AdamLaurie/RFIDler/windows-src/images/RFIDlerMon.png

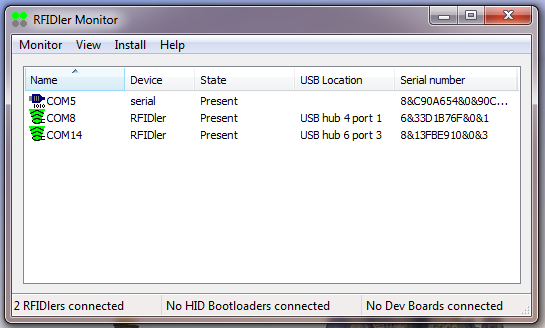
windows-src/images/RFIDlerMon.png
