AdamLaurie/RFIDler/python/example-plots/rfidler_plot_ask_recognition.png

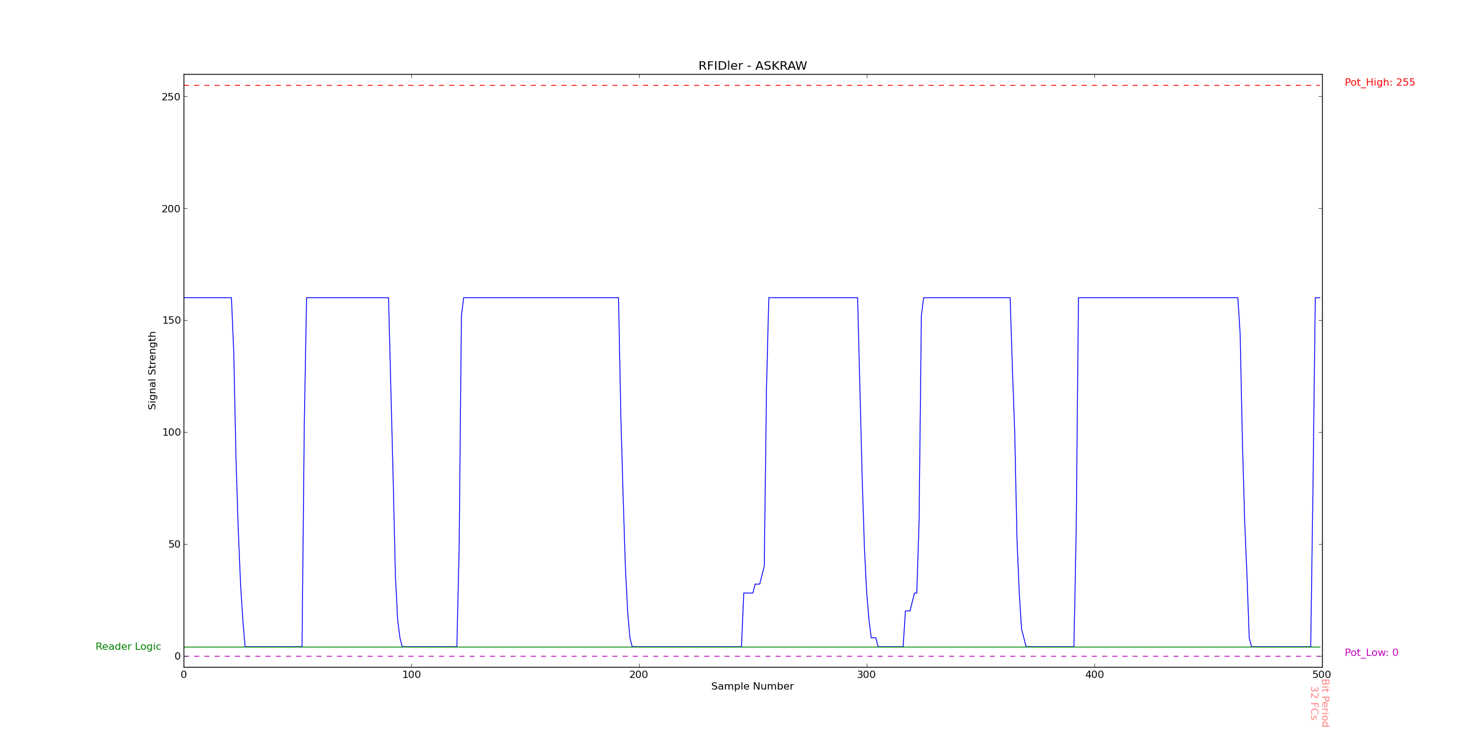
python/example-plots/rfidler_plot_ask_recognition.png
