AdamLaurie/RFIDler/python/example-plots/rfidler_plot_em4x02_134khz.png

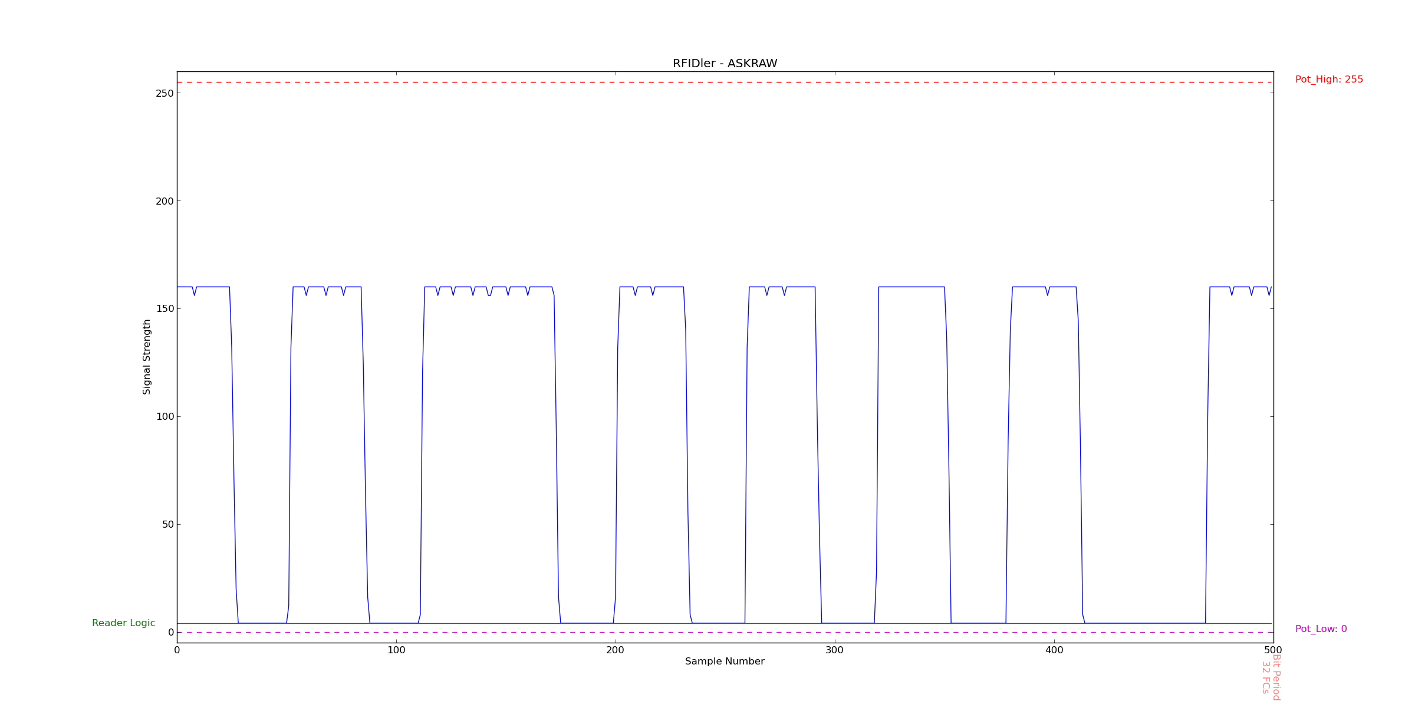
python/example-plots/rfidler_plot_em4x02_134khz.png
