AdamLaurie/RFIDler/python/example-plots/rfidler_plot_fsk_recognition.png

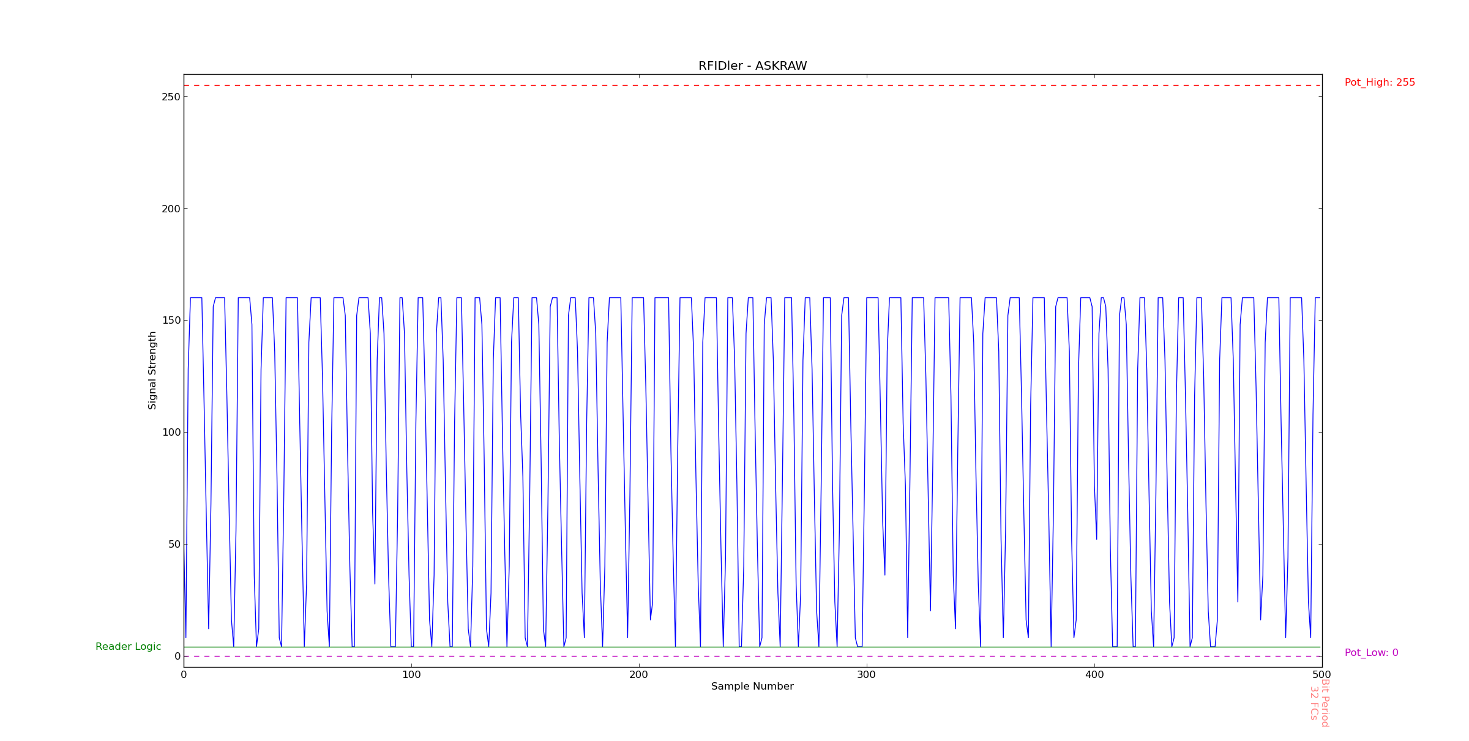
python/example-plots/rfidler_plot_fsk_recognition.png
