AdamLaurie/RFIDler/python/example-plots/rfidler_plot_hid_prox_125khz.png

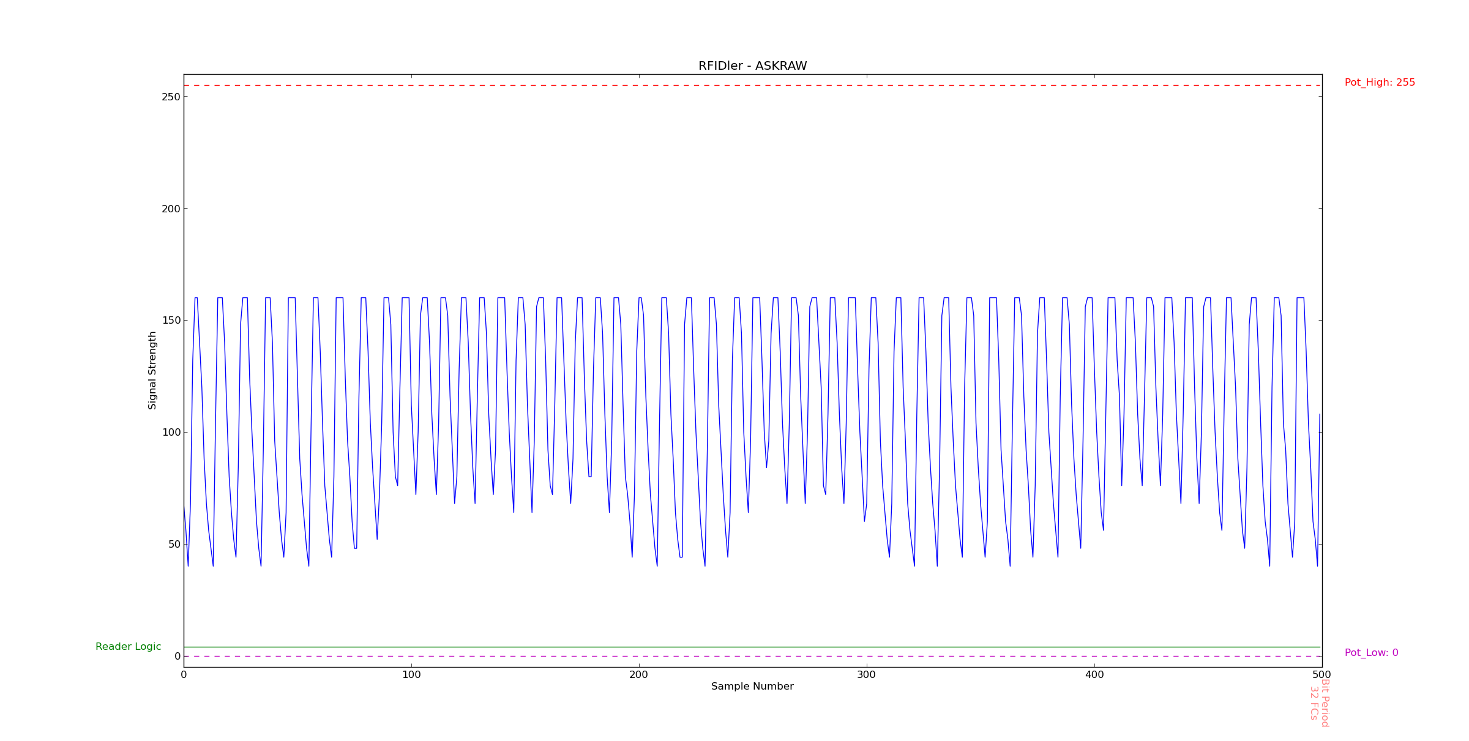
python/example-plots/rfidler_plot_hid_prox_125khz.png
