AdamLaurie/RFIDler/python/example-plots/rfidler_plot_hid_prox_134khz.png

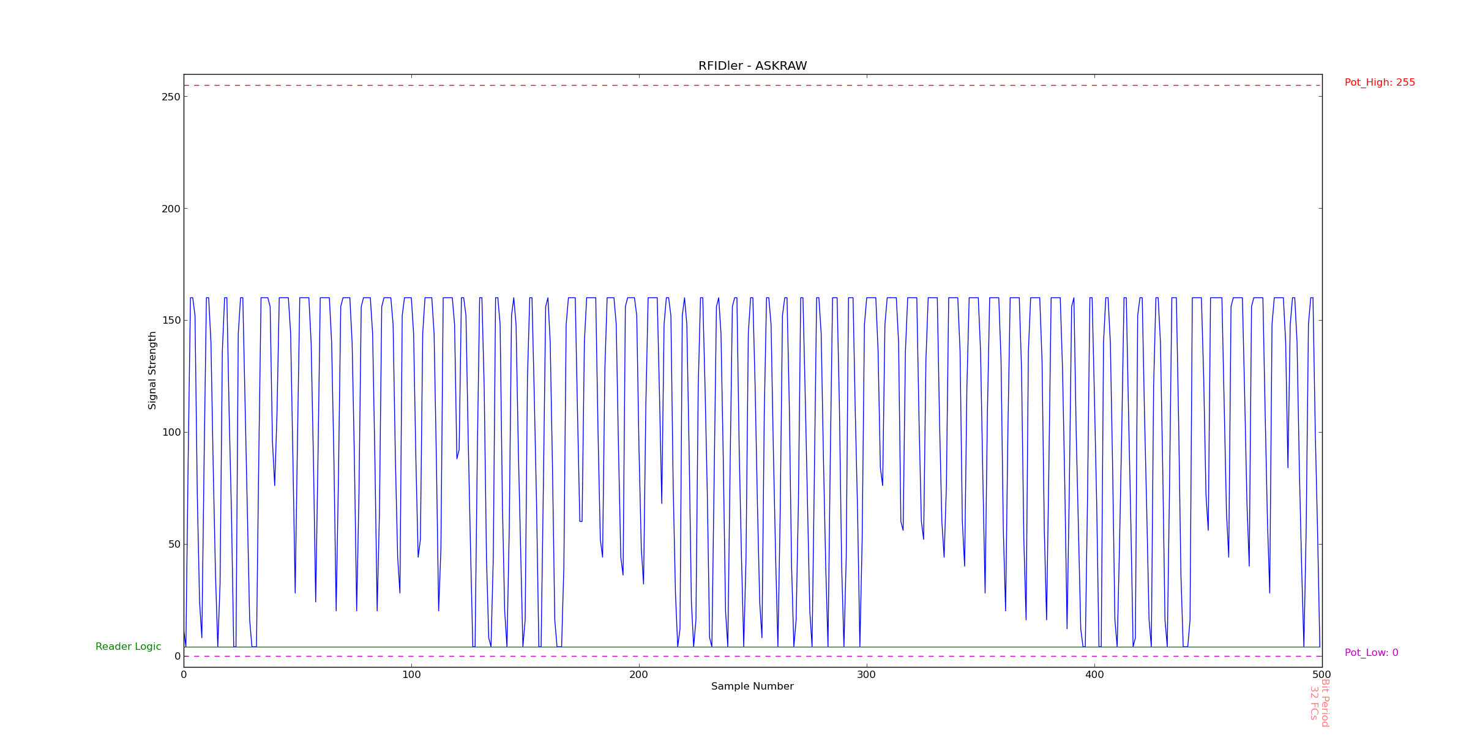
python/example-plots/rfidler_plot_hid_prox_134khz.png
