AdamLaurie/RFIDler/python/example-plots/rfidler_plot_psk_recognition.png

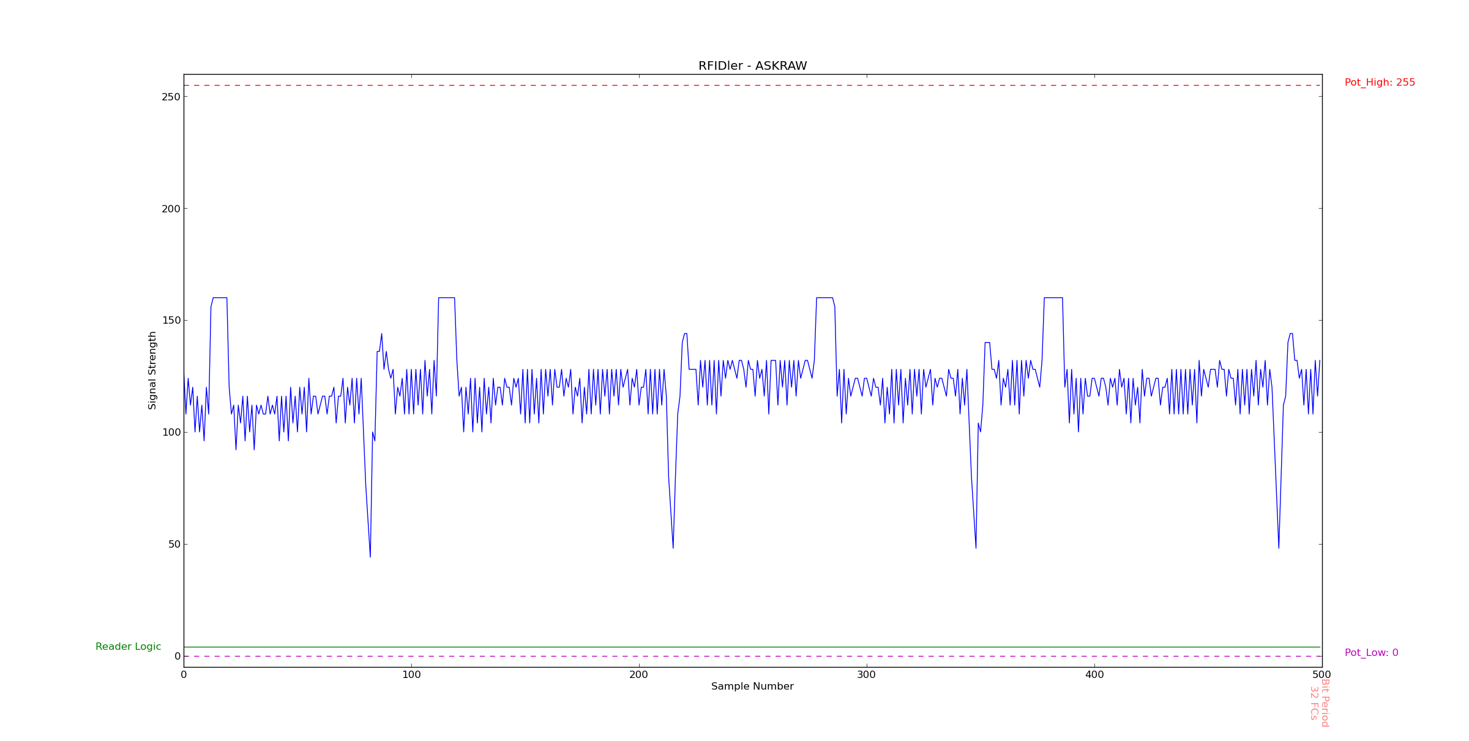
python/example-plots/rfidler_plot_psk_recognition.png
