AdamLaurie/RFIDler/windows driver/rfidler-install.txt

RFIDler LF appears to the computer as a USB serial port, and works with a standard 
Windows driver for USB serial ports, usbser.sys.

A simple driver information file rfidlercdc.inf tells Windows which driver to use, and 
such details as manufacturer (Aperture Labs Ltd) and product names (RFIDler LF).

This installer provides a simple interface to install or uninstall this file. (Note that 
complete uninstall only works on Windows XP, as Windows Vista & 7 keep a private copy.)

Alternatively to using the installer you can connect your RFIDler LF, find it in Windows 
Device Manager (via the Control Panel) and update the driver there. This program needs 
to run as local Administrator in order to copy files to, or remove files from, Windows 
protected directories.

Two versions of the installer are supplied: rfidlerinstall-x86.exe for 32-bit versions of 
Windows XP to Windows 7, and rfidlerinstall-x64.exe for 64-bit versions of Windows on x64 
CPUs.

Copyright (c) 2014 Anthony Naggs, all rights reserved.

Limited assignment of rights under the 'BSD 2-Clause License':

Redistribution and use in source and binary forms, with or without modification, are 
permitted provided that the following conditions are met:

1. Redistributions of source code must retain the above copyright notice, this list of
   conditions and the following disclaimer.

2. Redistributions in binary form must reproduce the above copyright notice, this list
   list of conditions and the following disclaimer in the documentation and/or other
   materials provided with the distribution.

THIS SOFTWARE IS PROVIDED BY THE COPYRIGHT HOLDERS AND CONTRIBUTORS "AS IS" AND ANY 
EXPRESS OR IMPLIED WARRANTIES, INCLUDING, BUT NOT LIMITED TO, THE IMPLIED WARRANTIES 
OF MERCHANTABILITY AND FITNESS FOR A PARTICULAR PURPOSE ARE DISCLAIMED. IN NO EVENT 
SHALL THE COPYRIGHT HOLDER OR CONTRIBUTORS BE LIABLE FOR ANY DIRECT, INDIRECT, 
INCIDENTAL, SPECIAL, EXEMPLARY, OR CONSEQUENTIAL DAMAGES (INCLUDING, BUT NOT LIMITED 
TO, PROCUREMENT OF SUBSTITUTE GOODS OR SERVICES; LOSS OF USE, DATA, ORPROFITS; OR 
BUSINESS INTERRUPTION) HOWEVER CAUSED AND ON ANY THEORY OF LIABILITY, WHETHER IN 
CONTRACT, STRICT LIABILITY, OR TORT (INCLUDING NEGLIGENCE OR OTHERWISE) ARISING IN 
ANY WAY OUT OF THE USE OF THIS SOFTWARE, EVEN IF ADVISED OF THE POSSIBILITY OF SUCH 
DAMAGE.
