AdamLaurie/RFIDler/python/example-plots/rfidler_plot_mystery_tag3_step1.png

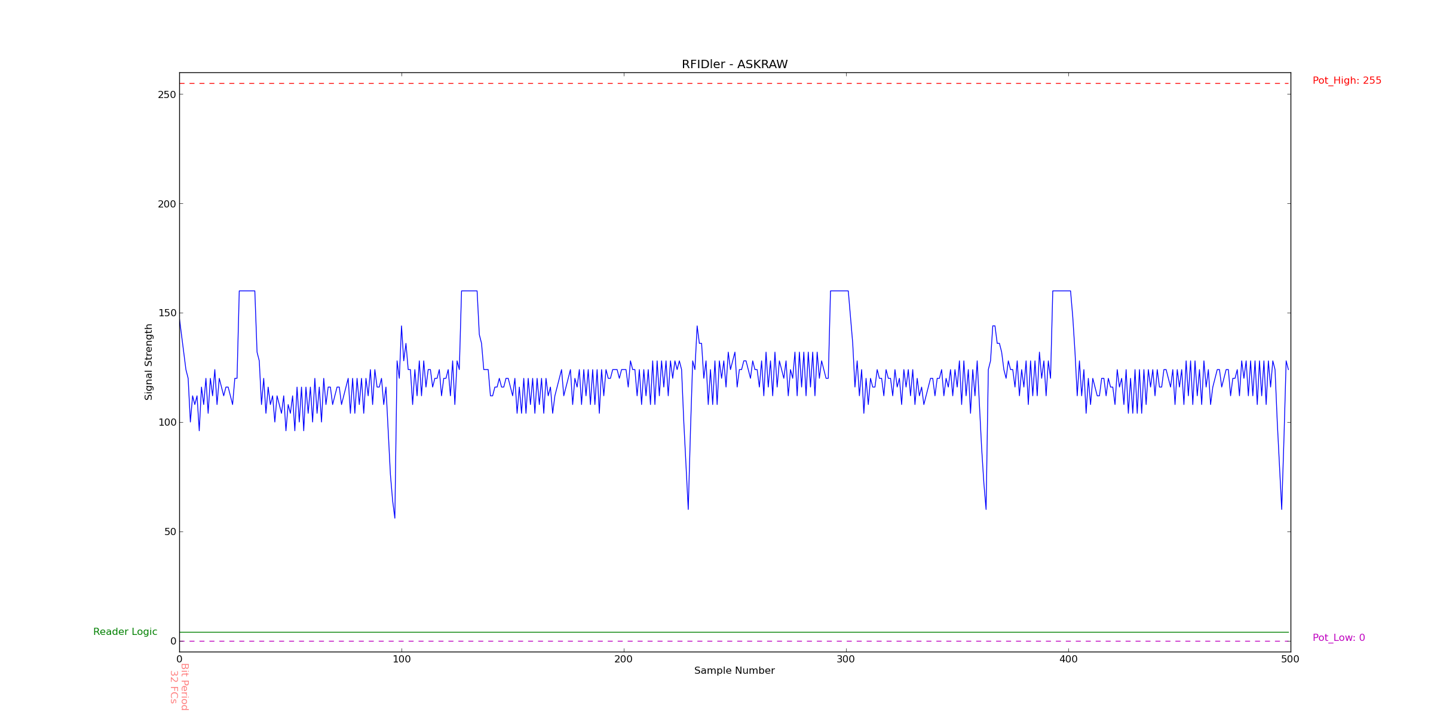
python/example-plots/rfidler_plot_mystery_tag3_step1.png
