AdamLaurie/RFIDler/python/example-plots/rfidler_plot_mystery_tag_step2.png

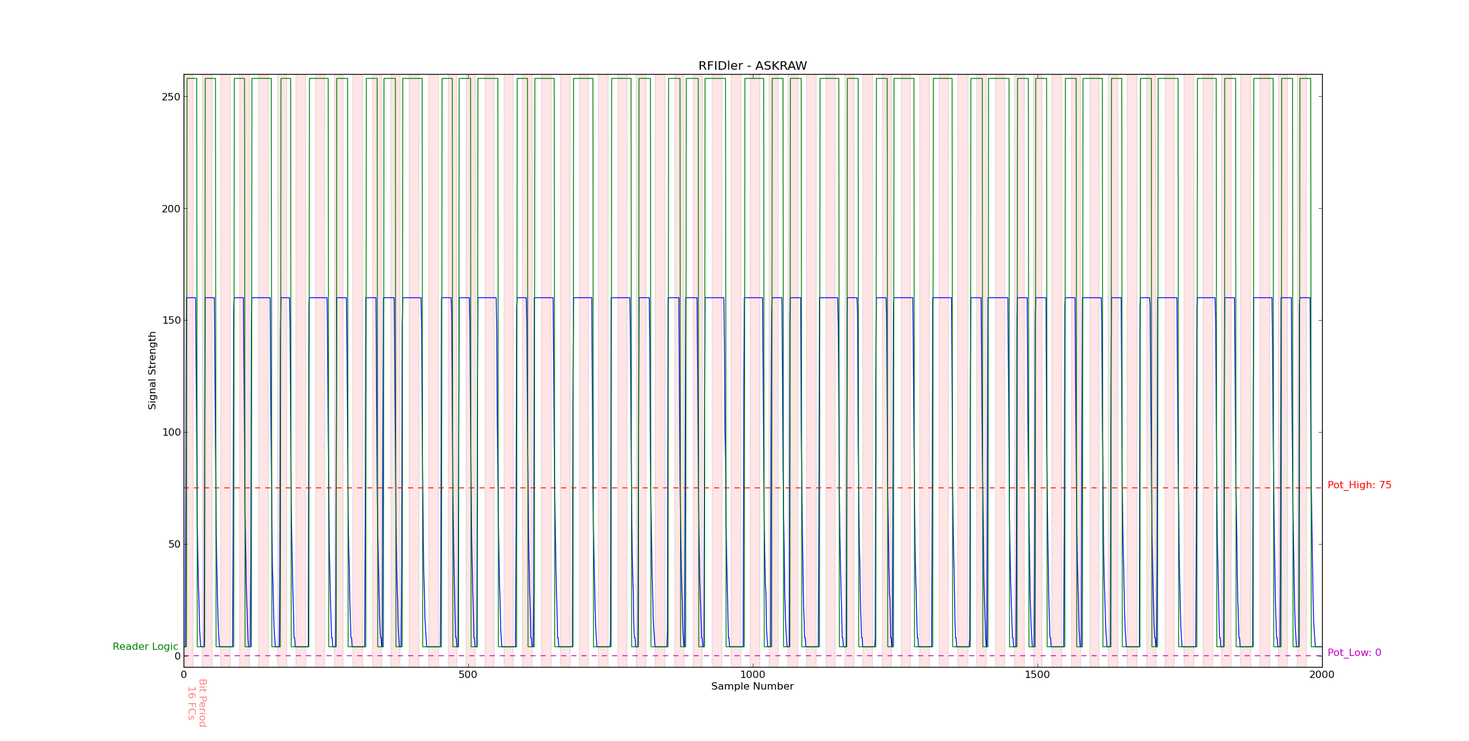
python/example-plots/rfidler_plot_mystery_tag_step2.png
