AdamLaurie/RFIDler/python/example-plots/rfidler_plot_mystery_tag_step3.png

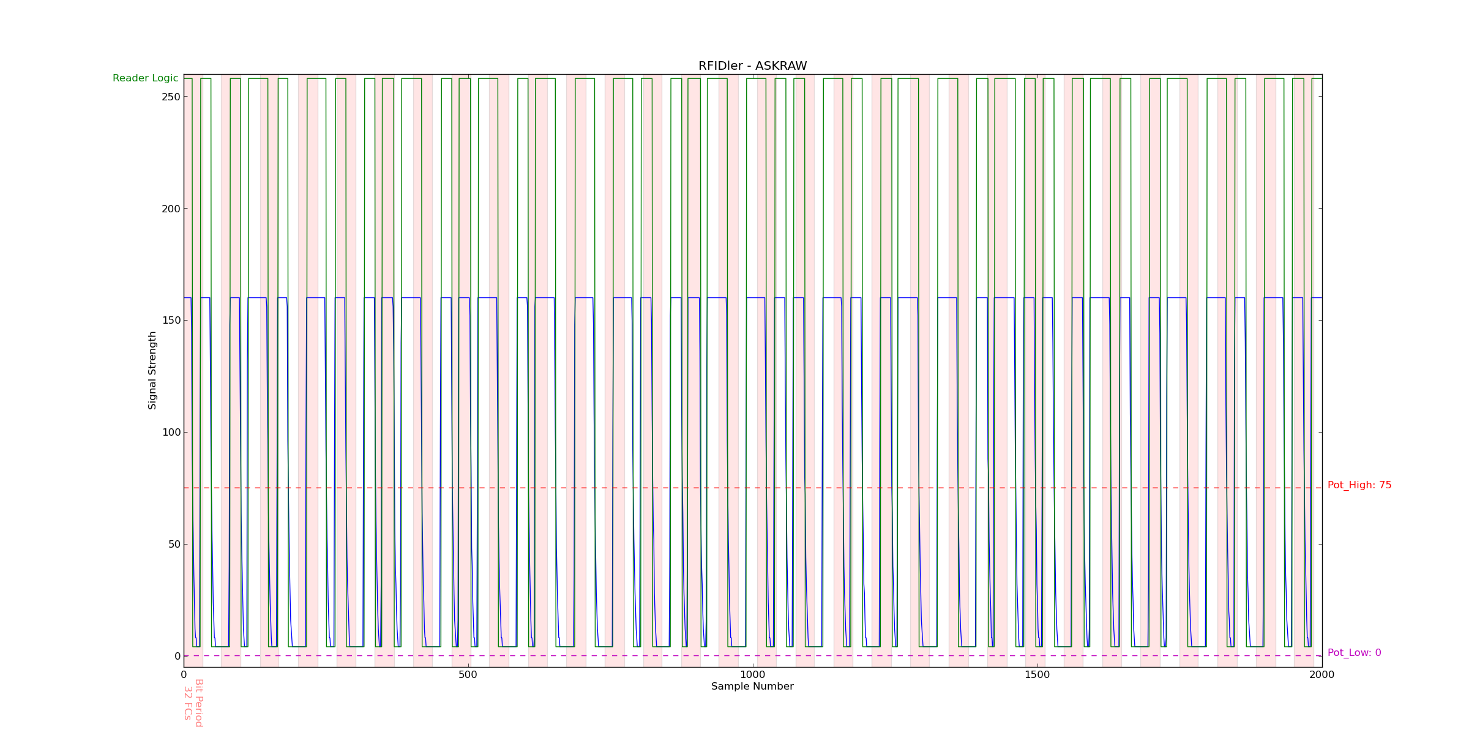
python/example-plots/rfidler_plot_mystery_tag_step3.png
