AdamLaurie/RFIDler/(threads)

Thread 26 (2015-07-18):

Complete No0B Here! How do I get this stuff working!?!

cavebear541, 2015-07-18:
I am at a complete loss as to how I am supposed to get my RFIDler working. Is there a way to just download a program that has all I need to get it working? The instructions in the read me are confusing and beyond my expertise. I need a guide for beginners!

tonynaggs, 2015-07-19:
You need a Mac, Unix or Windows PC to connect to, and USB cable with a mini USB connector to connect to the Rfidler. (I have also heard of people connecting to an Android phone with USB OTG, but you probably need external power in this case.)

The Rfidler will look like a new serial port, and you can use your favourite terminal programming to connect & talk with it.

We really need to know what you're connecting your Rfidler to, and what you have done to set it up to in order to give more specific advice!

cavebear541, 2015-07-19:
I'm connecting it to a PC.

tonynaggs, 2015-07-19:
1. Our support forum is here: [http://rfidler.org/] (http://rfidler.org/)

2. "a PC" is not sufficient information for anyone to understand your problem and help you:
    you need to state what operating system (Mac OS, Linux, Windows, etc) and version you have,
    also what you have tried (software you have installed or struggled with),
    and what does & does not work (for example do the LEDs on the Rfidler light when you plug it in).

3. Github issues are for reporting bugs in the supplied software, or feature requests.
    Using the forum for support requests means more people can read your questions and offer replies.

cavebear541, 2015-07-19:
I have Windows 7, when I plug the RFIDler into the computer the lights on the device light up.
My problem is that I don't know which software I need to be using. This website has a number of different ones it talks about using, none of which I can figure out. All I know how to do at this moment is how to plug the device into my computer. Does anyone know which software I need to download or an instruction manual is located?

tonynaggs, 2015-07-20:
Cool, I'm using Windows 7 too.

My plan this week includes blogging on:
* How to use Rfidler with Windows XP or 7, including Windows bugs to work around and what tools to install.

* Features and roadmap for the Rfidler Windows tools I have written.

Sorry these don't exist already.

fabiand93, 2015-07-25:
I'm using a Mac OS Yosemite, and I'm lost too

Closed 2015-07-19.

Thread 29 (2016-02-10):

autotag stalls at HDX

mubix, 2016-02-10:
It just stalls and never finishes

Current version: 0187-beta
```
RFIDler> version
0187-beta
RFIDler> autotag
  ASKRAW: 9<removed data>
  FSK1RAW:
  FSK2RAW:
  PSK1RAW:
  PSK2RAW:
  PSK3RAW:
  HITAG1:
  HITAG2:
  EM4X02:
  Q5:
  HID26:
  INDALA64:
  INDALA224:
  UNIQUE:
  FDXB:
  T55X7:
  AWID26:
  EM4X05:
  TAMAGOTCHI:
  HDX:

```

eficker, 2016-02-10:
I haven't had a lot of success with this function either. In my experience, the RFIDler is great at writing tags but okay at reading. The odd part is that it will write flawlessly the first time, but getting it to read (with the same provided antenna) is difficult and requires a lot of repositioning of the badge.

bvernoux, 2016-03-13:
I confirm this issue and also the fact that I have 2 TI HDX - FSK 134.2kHz tags (http://www.ti.com/lit/ds/symlink/trpgr30tgc.pdf & http://www.ti.com/lit/ds/symlink/ri-trp-r9ql.pdf) which cannot be detected correctly even using https://github.com/ApertureLabsLtd/RFIDler/wiki/plotting => with'set tag fsk2raw' with different settings (signal is too low)

AdamLaurie, 2016-03-13:
HDX is a work in progress and unfortunately I ran out of time on it when only half way through... I've disabled it altogether until I get a chance to finish it (or someone else does :). I'll leave this issue open as a reminder though.

Thread 34 (2018-01-13):

flashing firmware on windows

MarcusWolschon, 2018-01-13:
The "Windows" section in README.MD for flashing a new firmware version still only consists of "???".
The "Windows" and "MacOS" section of the "firmware" wiki page on Github are empty.

There is some information in the forum at
http://rfidler.org/index.php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
but it does not tell where to get HIDBootloader.exe

There does not seem to be named releases on Github and no obvious version.h or similar file to look up what a current version number should look like.
So I have no idea if "0114-beta" the board tells me is terribly outdated or current and
no way of updating the firmware to the latest file from firmware/Pic32/RFIDler.X/dist/debug/production/RFIDler.X.production.hex

MarcusWolschon, 2018-01-13:
I seem to have found the current place to download binaries of the flashing application.
This is what should be in the readme:
http://marcuswolschon.blogspot.de/2018/01/using-rfidler-on-windows.html

Also a wiki page or something explaining all the CLI commands would be reasonable.

Thread 37 (2019-11-28):

Hitag2 SNIFF-PWM list stored

banannd, 2019-11-28:
Hi,
 I have problem with SNIFF-PWM list stored option, becouse when I do procedure on my RFIDler:
SET TAG HITAG2
SNIFF-PWM C
AUTORUN SNIFF-PWM S
SAVE
• Power RFIDler from USB battery
• RFIDler antenna on RWD, present tag (n times)
and comands "SNIFF-PWM L" return:
"No HiTag2 PWM stored"
where is the problem?

Thread 40 (2020-10-02):

new crack2,3,4 usage

p3im4n, 2020-10-02:
hi
at first I apologize for my bad english
Special thanks to Mr AdamLaurie for his great RFIDlr device
after weeks finally I could compile mcu and windows projects,but there is no usage of hitag2crack folder and its  cracks source file!!
although Author(Kevin Sheldrakein) describes how to use these cracks by RFIDlr device in README file
is any one there who try that cracks ?
best regards

Thread 45 (2024-07-16):

http://rfidiot.org/ Down?

HeIp, 2024-07-16:
[http://rfidiot.org/](http://rfidiot.org/#Hardware) website seems to not be working ?

SteveClement, 2024-07-18:
Indeed :( @AdamLaurie

AdamLaurie, 2024-07-18:
Yes - I'm working on it. My service provider had a major outage and lost
the VM it was running on :(

Thanks for the head's up!

Hope you're well!

cheers,
Adam

On Thu, Jul 18, 2024 at 3:53 PM Steve Clement ***@***.***>
wrote:

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
