AdamLaurie/RFIDler/Hardware/Pic32/RFIDLER V22 beta.brd

## EAGLE design Hardware/Pic32/RFIDLER V22 beta.brd (2014-06-19)

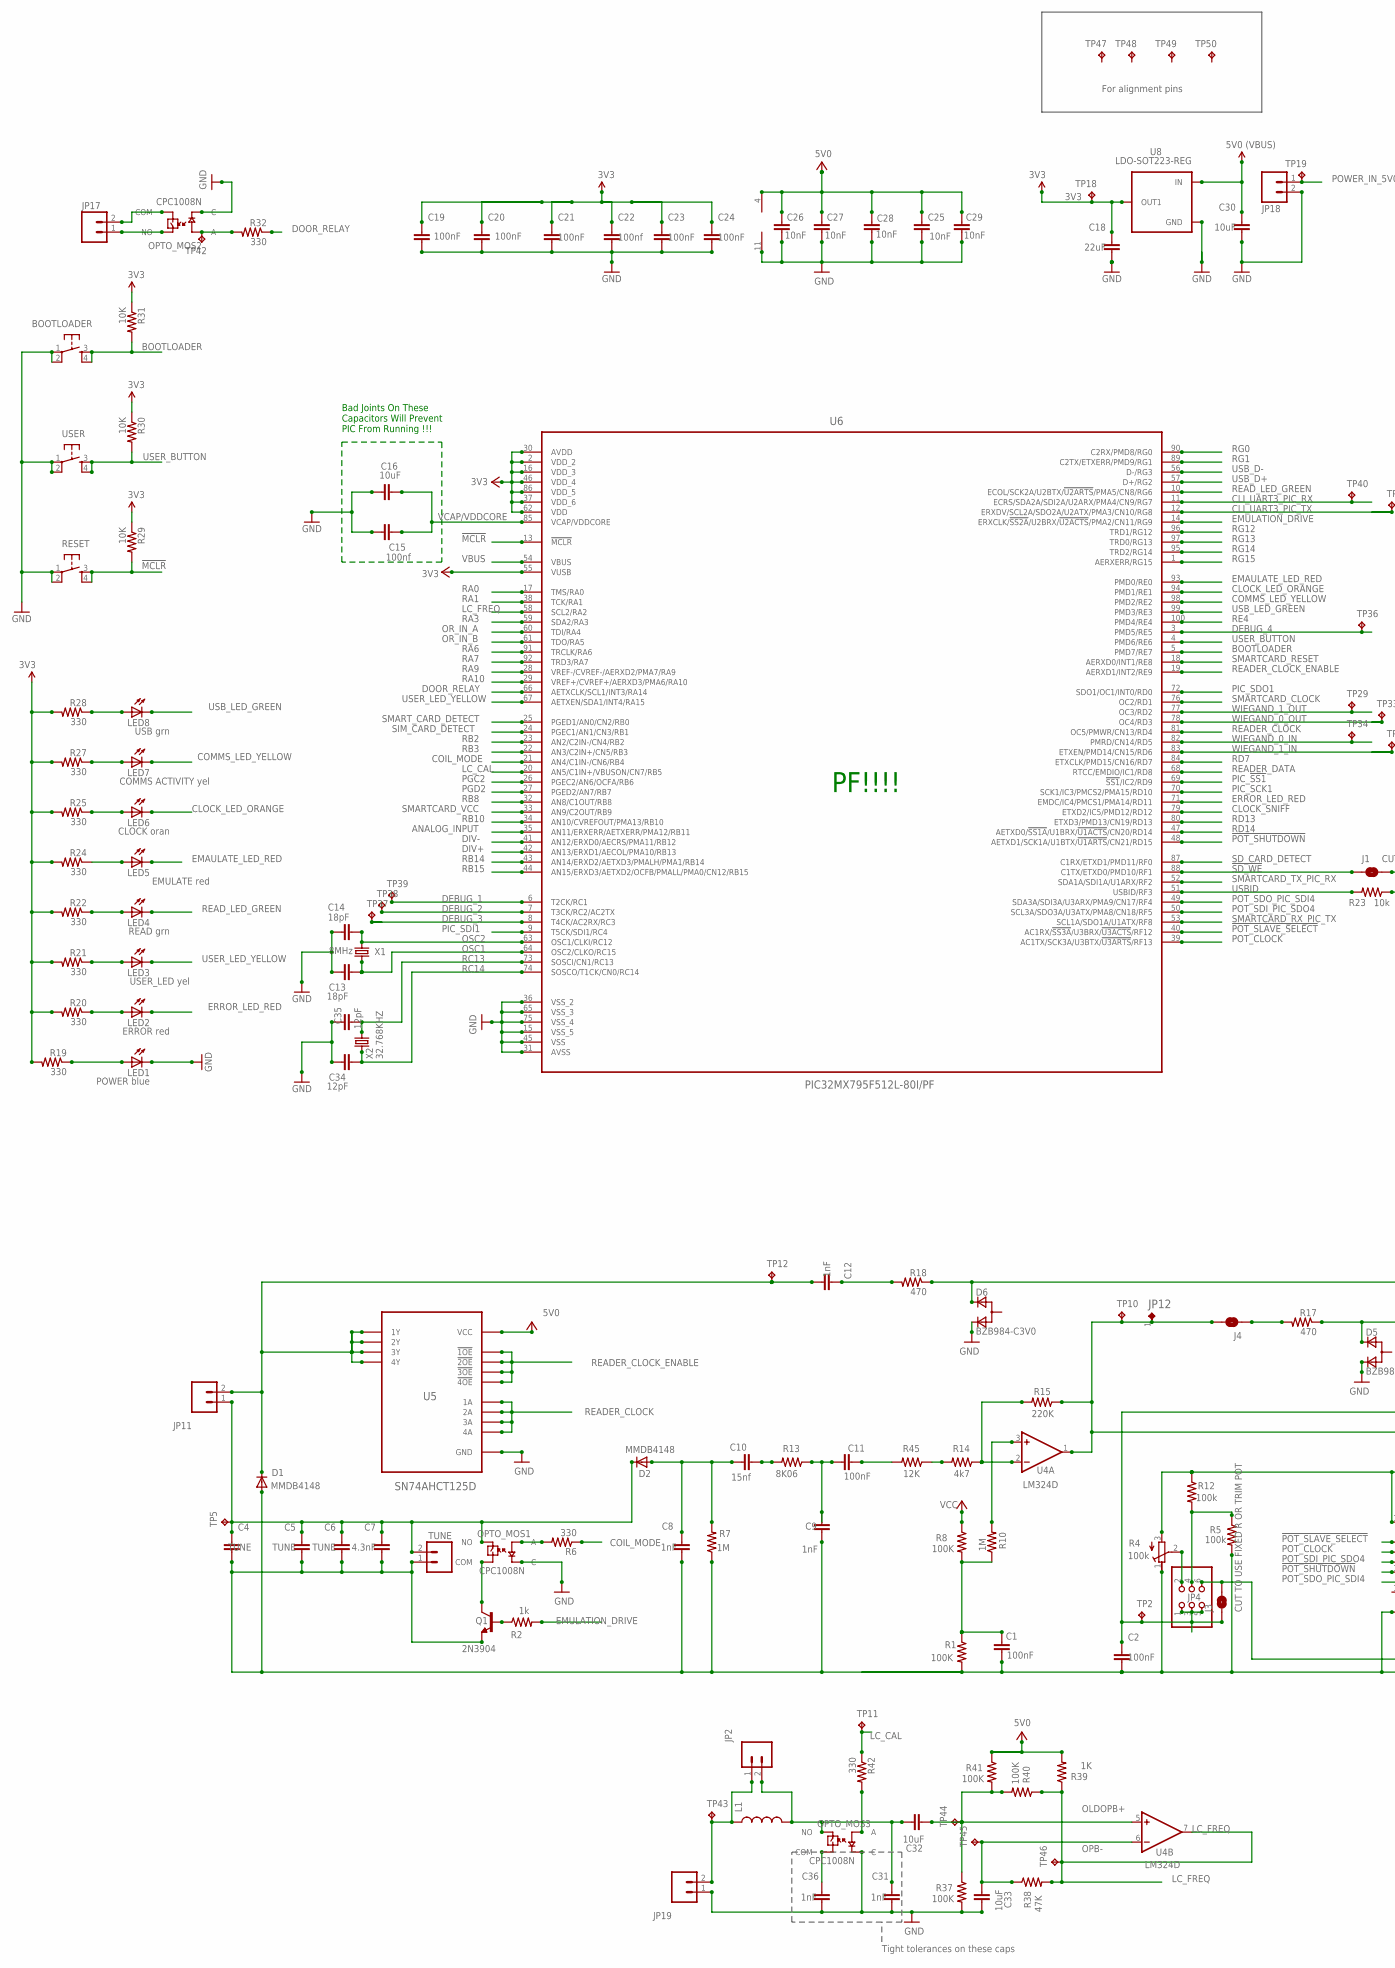
[picture p18: schematic RFIDLER V22 beta.sch, part in row 1, column 1]

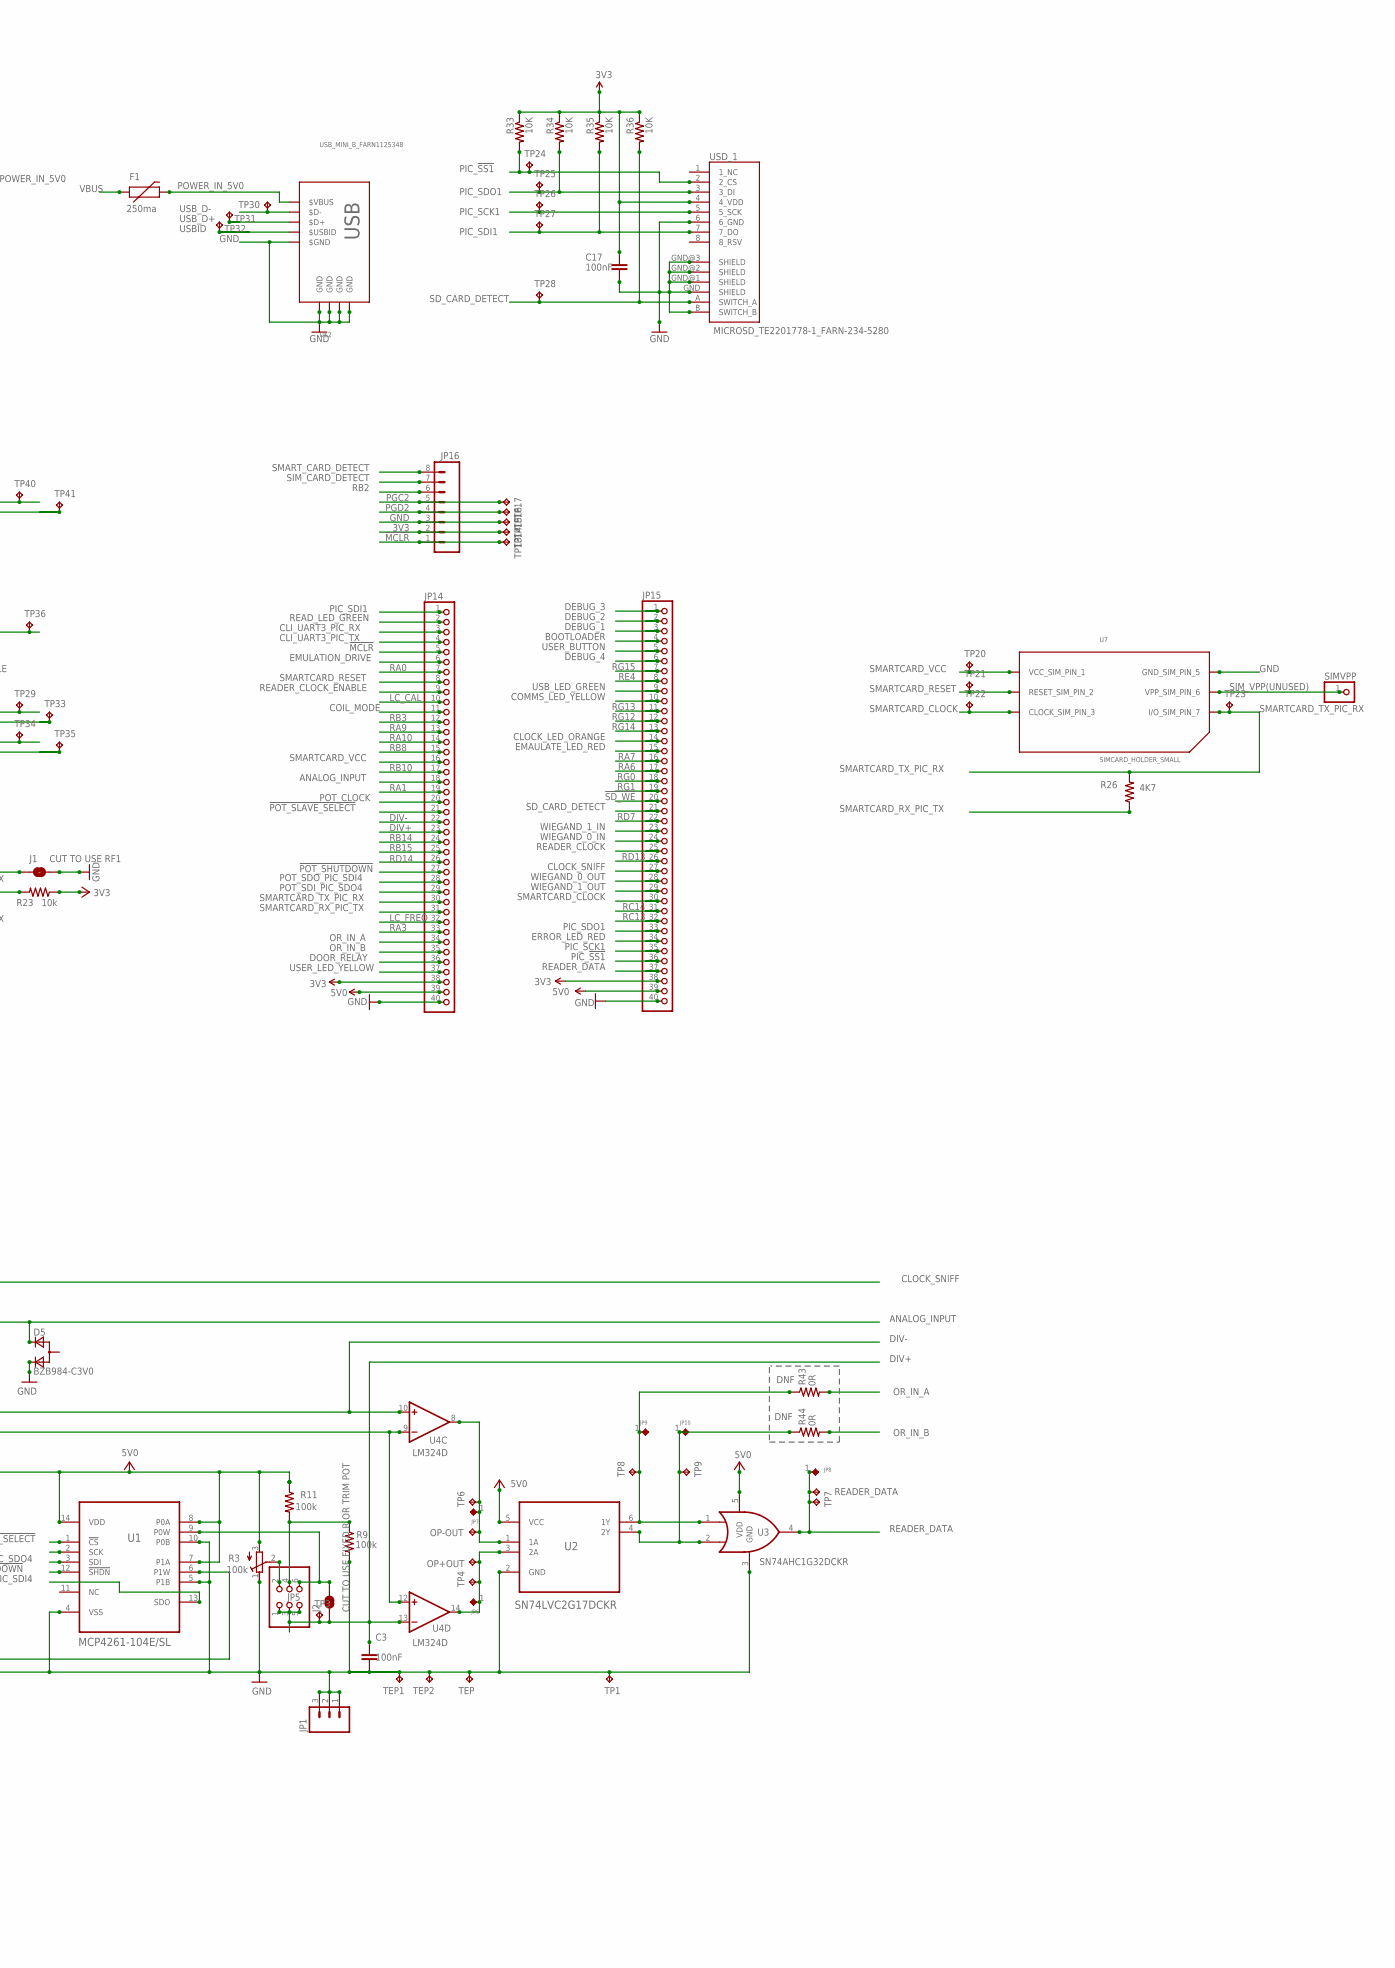
[picture p19: schematic RFIDLER V22 beta.sch, part in row 1, column 2]

Parts:
BOOTLOADER: TAC_SWITCHSMD; TACTILE_SWITCH_SMD; TOLERANCE ?; FARNELL 9471880
C1: 100nF; 0603-CAP; TOLERANCE ?; PARTNO currently rs 264-4646; FARNELL 2332586
C2: 100nF; C0603; TOLERANCE ?; PARTNO currently rs 264-4646; FARNELL 2332586
C3: 100nF; C0603; TOLERANCE ?; PARTNO ?; FARNELL 2332586
C4, C5, C6: TUNE; C0603; TOLERANCE ?; PARTNO ?; FARNELL DNF
C7: 4.3nF; C0603; TOLERANCE 1%; PARTNO ?; FARNELL 1865494
C8, C9, C12: 1nF; C0603; TOLERANCE ?; PARTNO ?; FARNELL 1414606
C10: 15nf; C0603; TOLERANCE ?; PARTNO ?; FARNELL 2070401
C11: 100nF; C0603; TOLERANCE ?; PARTNO currently rs2644646; FARNELL 2332586
C13, C14: 18pF; C0603; TOLERANCE ?; FARNELL 1612182
C15: 100nf; C0603; TOLERANCE Cuurently rs 264 4646; FARNELL 2332586
C16, C30: 10uF; C0805; TOLERANCE ?; FARNELL 1867958
C17: 100nF; C0603; TOLERANCE Crrently rs 264 4646; FARNELL DNF
C18: 22uF; C0805; TOLERANCE ?; FARNELL 1867956
C19, C20, C21, C23, C24: 100nF; C0603; TOLERANCE Crrently rs 264 4646; FARNELL 2332586
C22: 100nf; C0603; TOLERANCE Crrently rs 264 4646; FARNELL 2332586
C25, C26, C27, C28, C29: 10nF; C0603; TOLERANCE ?; PARTNO ?; FARNELL 1301715
C31, C36: 1nF; C0603; TOLERANCE ?; PARTNO ?; FARNELL DNF
C32, C33: 10uF; C0805; TOLERANCE ?; FARNELL DNF
C34, C35: 12pF; C0603; TOLERANCE ?; FARNELL DNF
D1, D2: MMDB4148; SOT23-3; TOLERANCE ?; PARTNO ?; FARNELL 2069338
D5, D6: BZB984-C3V0; SOT663; FARNELL 8735310
F1: 250ma; PTC-1206; FARNELL 1596990
J1: CUT TO USE RF1; SJ_2S-TRACE
J2, J3: CUT TO USE FIXED R OR TRIM POT; SJ_2S-TRACE
J4: SOLDERJUMPERTRACE; SJ_2S-TRACE
JP1: M03LOCK_LONGPADS; 1X03_LOCK_LONGPADS; FARNELL DNF
JP2, JP18, JP19: M02LOCK_LONGPADS; 1X02_LOCK_LONGPADS; TOLERANCE ?; PARTNO ?; FARNELL DNF
JP4, JP5: PINHD-2X3; 2X03; TOLERANCE ?; PARTNO ?; FARNELL DNF
JP6, JP7, JP8, JP9, JP10, JP12: PINHD-1X1; 1X01; TOLERANCE ?; FARNELL DNF
JP11: M02LOCK_LONGPADS; 1X02_LOCK_LONGPADS; TOLERANCE ?; PARTNO ?; FARNELL 1550562 standard 2 PIN HEADER
JP14, JP15: PINHD-1X40; 1X40; FARNELL DNF
JP16: M08; 1X08; TOLERANCE ?; FARNELL DNF
JP17: M02LOCK_LONGPADS; 1X02_LOCK_LONGPADS; FARNELL DNF
L1: INDUCTOR0603; 0603; FARNELL DNF
LED1: POWER blue; LED-0603; TOLERANCE ?; FARNELL 2217972
LED2: ERROR red; LED-0603; TOLERANCE ?; FARNELL 2099221
LED3: USER_LED yel; LED-0603; TOLERANCE ?; FARNELL 2146436
LED4: READ grn; LED-0603; TOLERANCE ?; FARNELL 2146434
LED5: EMULATE red; LED-0603; TOLERANCE ?; FARNELL 2099221
LED6: CLOCK oran; LED-0603; TOLERANCE ?; FARNELL 2146433
LED7: COMMS ACTIVITY yel; LED-0603; TOLERANCE ?; FARNELL 2146436
LED8: USB grn; LED-0603; TOLERANCE ?; FARNELL 2146434
OP+OUT: TPPAD1-13; P1-13; TOLERANCE ?; PARTNO ?; FARNELL ?
OP-OUT: TPPAD1-13; P1-13; TOLERANCE ?; PARTNO ?; FARNELL ?
OPTO_MOS1: CPC1008N; FARNELL 1653755
OPTO_MOS2, OPTO_MOS3: CPC1008N; FARNELL DNF
Q1: 2N3904; SOT323; TOLERANCE ?; PARTNO ?; FARNELL 1459102
R1, R8: 100K; R0603; TOLERANCE ?; PARTNO ?; FARNELL 9330402
R2: 1k; R0603; TOLERANCE ?; PARTNO ?; FARNELL 9238484
R3, R4: 100k; RTRIMT93XA; TOLERANCE ?; PARTNO ?; FARNELL DNF
R5, R9, R11, R12: 100k; R0603; TOLERANCE ?; PARTNO ?; FARNELL 9330402
R6, R19, R20, R21, R22, R24, R25, R27, R28: 330; R0603; TOLERANCE ?; FARNELL 9332014
R7, R10: 1M; R0603; TOLERANCE ?; PARTNO ?; FARNELL 1469746
R13: 8K06; R0603; TOLERANCE ?; PARTNO ?; FARNELL 1170881
R14: 4k7; R0603; TOLERANCE ?; PARTNO ?; FARNELL 2078913
R15: 220K; R0603; TOLERANCE ?; PARTNO ?; FARNELL 2073431
R17, R18: 470; R0603; TOLERANCE ?; FARNELL 2333530
R23: 10k; R0603; TOLERANCE ?; PARTNO ?; FARNELL 9330399
R26: 4K7; R0603; TOLERANCE ?; PARTNO ?; FARNELL DNF
R29, R30, R31: 10K; R0603; TOLERANCE ?; FARNELL 9330399
R32, R42: 330; R0603; TOLERANCE ?; FARNELL DNF
R33, R34, R35, R36: 10K; R0603; TOLERANCE ?; FARNELL DNF
R37, R40, R41: 100K; R0603; TOLERANCE ?; PARTNO ?; FARNELL DNF
R38: 47K; R0603; TOLERANCE ?; PARTNO ?; FARNELL DNF
R39: 1K; R0603; TOLERANCE ?; PARTNO ?; FARNELL DNF
R43, R44: 0R; R0603; TOLERANCE ?; PARTNO ?; FARNELL DNF
R45: 12K; R0603; TOLERANCE ?; PARTNO ?; FARNELL 1652834
READER_DATA: TPPAD1-13; P1-13; TOLERANCE ?; PARTNO ?; FARNELL DNF
RESET: TAC_SWITCHSMD; TACTILE_SWITCH_SMD; TOLERANCE ?; FARNELL 9471880
SIMVPP: PINHD-1X1; 1X01; FARNELL DNF
TEP, TEP1, TEP2: TPPAD1-13; P1-13; TOLERANCE ?; PARTNO ?; FARNELL DNF
TP1, TP9, TP18: DOWNS_ORIN1; TP20R
TP2: DIV-; TP20R
TP3: DIV+; TP20R
TP4: OP-OUT; TP20R
TP5: COIL_B; TP20R
TP6: OP+OUT; TP20R
TP7: READER_DATA; TP20R
TP8: UPS_ORIN1; TP20R
TP10: RAW_READER_OUT; TP20R
TP11: LC_CAL; TP20R
TP12: COIL_A; TP20R
TP13: !MCLR; TP20R
TP14: 3V3; TP20R
TP15: GND; TP20R
TP16: PGD2; TP20R
TP17: PGC2; TP20R
TP19: POWER_IN_5V0; TP20R
TP20: SMARTCARD_VCC; TP20R
TP21: SMARTCARD_RESET; TP20R
TP22: SMARTCARD_CLOCK; TP20R
TP23: SMARTCARD_TX_PIC_RX; TP20R
TP24: PIC_!SS1; TP20R
TP25: PIC_SDO1; TP20R
TP26: PIC_SCK1; TP20R
TP27: PIC_SDI1; TP20R
TP28: SD_CARD_DETECT; TP20R
TP29: WIEGAND_1_OUT; TP20R
TP30: USB_D-; TP20R
TP31: USB_D+; TP20R
TP32: USBID; TP20R
TP33: WIE0OUT; TP20R
TP34: WIE0IN; TP20R
TP35: WIE1IN; TP20R
TP36: DEBUG_4; TP20R
TP37: DEBUG_3; TP20R
TP38: DEBUG_2; TP20R
TP39: DEBUG_1; TP20R
TP40: CLI_UART3_PIC_RX; TP20R
TP41: CLI_UART3_PIC_TX; TP20R
TP42: RELAY; TP20R
TP43: LC_COIL; TP20R
TP44: LC+; TP20R
TP45: LC-; TP20R
TP46: LCOUT; TP20R
TP47: PEG4; TP20R
TP48: PEG1; TP20R
TP49: PEG3; TP20R
TP50: PEG2; TP20R
TUNE: M02LOCK_LONGPADS; 1X02_LOCK_LONGPADS; TOLERANCE ?; PARTNO ?; FARNELL DNF
U1: MCP4261-104E/SL; SOIC127P600X175-14N; TOLERANCE ?; PARTNO ?; FARNELL 1840694
U2: SN74LVC2G17DCKR; SOT65P210X110-6N; TOLERANCE ?; PARTNO ?; FARNELL 1287569
U3: SN74AHC1G32DCKR; SC70-5L; TOLERANCE ?; PARTNO ?; FARNELL 1287449
U4: LM324D; SO14; TOLERANCE ?; PARTNO ?; FARNELL 8389233
U5: SN74AHCT125D; SOIC127P600X175-14N; FARNELL 1287453
U6: PIC32MX795F512L-80I/PF; QFP50P1600X1600X120-100N; TOLERANCE ?; FARNELL 1778491
U7: SIMCARD_HOLDER_SMALL; SIM_CARD_CONN; FARNELL DNF
U8: LDO-SOT223-REG; SOT223; FARNELL 9778195
U$2: USB_MINI_B_FARN1125348; FARNELL 1125348
USD_1: MICROSD_TE2201778-1_FARN-234-5280; FARNELL DNF
USER: TAC_SWITCHSMD; TACTILE_SWITCH_SMD; TOLERANCE ?; FARNELL 9471880
X1: 8MHz; HC49UP; TOLERANCE ?; FARNELL 1842346
X2: 32.768KHZ; TC38H; FARNELL DNF

Connections:
3V3: C17.1, C18.1, C19.1, C20.1, C21.1, C22.1, C23.1, C24.1, JP14.38, JP15.38, JP16.2, R19.2, R20.2, R21.2, R22.2, R23.1, R24.2, R25.2, R27.2, R28.2, R29.1, R30.1, R31.1, R33.1, R34.1, R35.1, R36.1, TP14.TP, TP18.TP, U6.2 (VDD_2), U6.16 (VDD_3), U6.30 (AVDD), U6.37 (VDD_6), U6.46 (VDD_4), U6.55 (VUSB), U6.62 (VDD), U6.86 (VDD_5), U8.P$2@2 (OUT1), USD_1.4 (4_VDD)
!MCLR: JP14.5, JP16.1, R29.2, RESET.3, RESET.4, TP13.TP, U6.13 (!MCLR)
!POT_SHUTDOWN: JP14.27, U1.12 (!SHDN), U6.48 (AETXD1/SCK1A/U1BTX/!U1ARTS!/CN21/RD15)
!POT_SLAVE_SELECT: JP14.21, U1.1 (!CS), U6.40 (AC1RX/!SS3A!/U3BRX/!U3ACTS!/RF12)
!SD_WE: J1.1, JP15.20, U6.88 (C1TX/ETXD0/PMD10/RF1)
ANALOG_INPUT: D5.P$1 (C1), JP14.18, R17.1, U6.35 (AN11/ERXERR/AETXERR/PMA12/RB11)
BOOTLOADER: BOOTLOADER.3, BOOTLOADER.4, JP15.4, R31.2, U6.5 (PMD7/RE7)
CLI_UART3_PIC_RX: JP14.3, TP40.TP, U6.11 (ECRS/SDA2A/SDI2A/U2ARX/PMA4/CN9/RG7)
CLI_UART3_PIC_TX: JP14.4, TP41.TP, U6.12 (ERXDV/SCL2A/SDO2A/U2ATX/PMA3/CN10/RG8)
CLOCK: C12.2, D1.3 (C), JP11.2, TP12.TP, U5.3 (1Y), U5.6 (2Y), U5.8 (3Y), U5.11 (4Y)
CLOCK_LED_ORANGE: JP15.14, LED6.C, U6.94 (PMD1/RE1)
CLOCK_SNIFF: D6.P$1 (C1), JP15.27, R18.1, U6.79 (ETXD2/IC5/PMD12/RD12)
COIL: C4.1, C5.1, C6.1, C7.1, D2.3 (C), JP11.1, OPTO_MOS1.NO, TP5.TP, TUNE.2
COIL_MODE: JP14.11, R6.1, U6.21 (AN4/C1IN-/CN6/RB4)
COMMS_LED_YELLOW: JP15.10, LED7.C, U6.98 (PMD2/RE2)
DEBUG_1: JP15.3, TP39.TP, U6.6 (T2CK/RC1)
DEBUG_2: JP15.2, TP38.TP, U6.7 (T3CK/RC2/AC2TX)
DEBUG_3: JP15.1, TP37.TP, U6.8 (T4CK/AC2RX/RC3)
DEBUG_4: JP15.6, TP36.TP, U6.3 (PMD5/RE5)
DIV+: C3.1, J2.1, JP5.1, JP5.3, JP5.5, JP14.23, TP3.TP, U4.13 (-IN), U6.42 (AN13/ERXD1/AECOL/PMA10/RB13)
DIV-: C2.1, J3.1, JP4.1, JP4.3, JP4.5, JP14.22, TP2.TP, U4.10 (+IN), U6.41 (AN12/ERXD0/AECRS/PMA11/RB12)
DOOR_RELAY: JP14.36, R32.1, U6.66 (AETXCLK/SCL1/INT3/RA14)
DOWNS_ORIN1: JP10.1, R44.1, TP9.TP, U2.4 (2Y), U3.2 (B)
EMAULATE_LED_RED: JP15.15, LED5.C, U6.93 (PMD0/RE0)
EMULATION_DRIVE: JP14.6, R2.2, U6.14 (ERXCLK/!SS2A!/U2BRX/!U2ACTS!/PMA2/CN11/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)
ERROR_LED_RED: JP15.34, LED2.C, U6.71 (EMDC/IC4/PMCS1/PMA14/RD11)
GND: BOOTLOADER.1, BOOTLOADER.2, C1.2, C2.2, C3.2, C4.2, C5.2, C6.2, C7.2, C8.2, C9.1, C13.1, C14.1, C15.2, C16.2, C17.2, C18.2, C19.2, C20.2, C21.2, C22.2, C23.2, C24.2, C25.1, C26.2, C27.2, C28.2, C29.2, C30.2, C31.2, C33.1, C34.1, C35.1, C36.2, D1.1 (A), D5.P$2 (C2), D6.P$2 (C2), J1.2, JP1.1, JP1.2, JP1.3, JP14.40, JP15.40, JP16.3, JP18.2, JP19.1, LED1.C, OPTO_MOS1.C, OPTO_MOS2.C, OPTO_MOS3.C, Q1.3 (E), R1.2, R3.1 (A), R4.1 (A), R5.2, R7.1, R9.2, R37.2, RESET.1, RESET.2, TEP.TP, TEP1.TP, TEP2.TP, TP1.TP, TP15.TP, TUNE.1, U1.4 (VSS), U1.5 (P1B), U1.10 (P0B), U2.2 (GND), U3.3 (GND), U4.11 (V-), U5.7 (GND), U6.15 (VSS_5), U6.31 (AVSS), U6.36 (VSS_2), U6.45 (VSS), U6.65 (VSS_3), U6.75 (VSS_4), U7.CARD_GND_PIN5 (GND_SIM_PIN_5), U8.P$1 (GND), U$2.GND ($GND), U$2.GND@1 (GND), U$2.GND@2 (GND), U$2.GND@3 (GND), U$2.GND@4 (GND), USD_1.6 (6_GND), USD_1.B (SWITCH_B), USD_1.GND (SHIELD), USD_1.GND@1 (SHIELD), USD_1.GND@2 (SHIELD), USD_1.GND@3 (SHIELD), USER.1, USER.2
LC_CAL: JP14.10, R42.1, TP11.TP, U6.20 (AN5/C1IN+/VBUSON/CN7/RB5)
LC_COIL: C31.1, C32.1, JP2.2, L1.2, OPTO_MOS3.NO
LC_FREQ: JP14.32, R38.2, R39.1, R40.1, TP46.TP, U4.7 (OUT), U6.58 (SCL2/RA2)
unnamed: JP4.2, R4.2 (S)
unnamed: OPTO_MOS3.A, R42.2
unnamed: C36.1, OPTO_MOS3.COM
unnamed: C8.1, C10.1, D2.1 (A), R7.2
unnamed: C10.2, R13.2
unnamed: C9.2, C11.2, R13.1
unnamed: C11.1, R45.2
unnamed: R14.1, R15.2, U4.2 (-IN)
unnamed: Q1.1 (B), R2.1
unnamed: JP2.1, JP19.2, L1.1, TP43.TP
unnamed: R10.2, U4.3 (+IN)
unnamed: J3.2, JP4.6, U1.6 (P1W)
unnamed: LED4.A, R22.1
unnamed: JP5.2, R3.2 (S)
unnamed: LED3.A, R21.1
unnamed: J2.2, JP5.6, U1.9 (P0W)
unnamed: OPTO_MOS1.COM, Q1.2 (C)
unnamed: JP4.4, R5.1, R12.2
unnamed: OPTO_MOS1.A, R6.2
unnamed: JP5.4, R9.1, R11.2
unnamed: C12.1, R18.2
unnamed: LED1.A, R19.1
unnamed: LED2.A, R20.1
unnamed: OPTO_MOS2.A, R32.2, TP42.TP
unnamed: JP17.1, OPTO_MOS2.NO
unnamed: JP17.2, OPTO_MOS2.COM
unnamed: J4.1, R17.2
unnamed: R14.2, R45.1
unnamed: LED8.A, R28.1
unnamed: LED7.A, R27.1
unnamed: LED5.A, R24.1
unnamed: LED6.A, R25.1
OLDOPB+: C32.2, R37.1, R40.2, R41.2, TP44.TP, U4.5 (+IN)
OP+OUT: JP7.1, OP-OUT.TP, TP6.TP, U2.1 (1A), U4.8 (OUT)
OP-OUT: JP6.1, OP+OUT.TP, TP4.TP, U2.3 (2A), U4.14 (OUT)
OPB-: C33.2, R38.1, TP45.TP, U4.6 (-IN)
OR_IN_A: JP14.34, R43.2, U6.60 (TDI/RA4)
OR_IN_B: JP14.35, R44.2, U6.61 (TDO/RA5)
OSC1: C13.2, U6.64 (OSC2/CLKO/RC15), X1.1
OSC2: C14.2, U6.63 (OSC1/CLKI/RC12), X1.2
PGC2: JP16.5, TP17.TP, U6.26 (PGEC2/AN6/OCFA/RB6)
PGD2: JP16.4, TP16.TP, U6.27 (PGED2/AN7/RB7)
PIC_!SS1: JP15.36, R33.2, TP24.TP, U6.69 (!SS1!/IC2/RD9), USD_1.2 (2_CS)
PIC_SCK1: JP15.35, TP26.TP, U6.70 (SCK1/IC3/PMCS2/PMA15/RD10), USD_1.5 (5_SCK)
PIC_SDI1: JP14.1, R35.2, TP27.TP, U6.9 (T5CK/SDI1/RC4), USD_1.7 (7_DO)
PIC_SDO1: JP15.33, R34.2, TP25.TP, U6.72 (SDO1/OC1/INT0/RD0), USD_1.3 (3_DI)
POT_CLOCK: JP14.20, U1.2 (SCK), U6.39 (AC1TX/SCK3A/U3BTX/!U3ARTS!/RF13)
POT_SDI_PIC_SDO4: JP14.29, U1.3 (SDI), U6.50 (SCL3A/SDO3A/U3ATX/PMA8/CN18/RF5)
POT_SDO_PIC_SDI4: JP14.28, U1.13 (SDO), U6.49 (SDA3A/SDI3A/U3ARX/PMA9/CN17/RF4)
POWER_IN_5V0: F1.2, JP18.1, TP19.TP, U$2.VBUS ($VBUS)
RA0: JP14.7, U6.17 (TMS/RA0)
RA1: JP14.19, U6.38 (TCK/RA1)
RA3: JP14.33, U6.59 (SDA2/RA3)
RA6: JP15.17, U6.91 (TRCLK/RA6)
RA7: JP15.16, U6.92 (TRD3/RA7)
RA9: JP14.13, U6.28 (VREF-/CVREF-/AERXD2/PMA7/RA9)
RA10: JP14.14, U6.29 (VREF+/CVREF+/AERXD3/PMA6/RA10)
RAW_READER_OUT: J4.2, JP12.1, R15.1, TP10.TP, U4.1 (OUT), U4.9 (-IN), U4.12 (+IN)
RB2: JP16.6, U6.23 (AN2/C2IN-/CN4/RB2)
RB3: JP14.12, U6.22 (AN3/C2IN+/CN5/RB3)
RB8: JP14.15, U6.32 (AN8/C1OUT/RB8)
RB10: JP14.17, U6.34 (AN10/CVREFOUT/PMA13/RB10)
RB14: JP14.24, U6.43 (AN14/ERXD2/AETXD3/PMALH/PMA1/RB14)
RB15: JP14.25, U6.44 (AN15/ERXD3/AETXD2/OCFB/PMALL/PMA0/CN12/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)
RC13: C35.2, JP15.32, U6.73 (SOSCI/CN1/RC13), X2.2
RC14: C34.2, JP15.31, U6.74 (SOSCO/T1CK/CN0/RC14), X2.1
RD7: JP15.22, U6.84 (ETXCLK/PMD15/CN16/RD7)
RD13: JP15.26, U6.80 (ETXD3/PMD13/CN19/RD13)
RD14: JP14.26, U6.47 (AETXD0/!SS1A!/U1BRX/!U1ACTS!/CN20/RD14)
RE4: JP15.8, U6.100 (PMD4/RE4)
READER_CLOCK: JP15.25, U5.2 (1A), U5.5 (2A), U5.9 (3A), U5.12 (4A), U6.81 (OC5/PMWR/CN13/RD4)
READER_CLOCK_ENABLE: JP14.9, U5.1 (!1OE), U5.4 (!2OE), U5.10 (!3OE), U5.13 (!4OE), U6.19 (AERXD1/INT2/RE9)
READER_DATA: JP8.1, JP15.37, READER_DATA.TP, TP7.TP, U3.4 (Y), U6.68 (RTCC/EMDIO/IC1/RD8)
READ_LED_GREEN: JP14.2, LED4.C, U6.10 (ECOL/SCK2A/U2BTX/!U2ARTS!/PMA5/CN8/RG6)
RG0: JP15.18, U6.90 (C2RX/PMD8/RG0)
RG1: JP15.19, U6.89 (C2TX/ETXERR/PMD9/RG1)
RG12: JP15.12, U6.96 (TRD1/RG12)
RG13: JP15.11, U6.97 (TRD0/RG13)
RG14: JP15.13, U6.95 (TRD2/RG14)
RG15: JP15.7, U6.1 (AERXERR/RG15)
SD_CARD_DETECT: JP15.21, R36.2, TP28.TP, U6.87 (C1RX/ETXD1/PMD11/RF0), USD_1.A (SWITCH_A)
SIM_CARD_DETECT: JP16.7, U6.24 (PGEC1/AN1/CN3/RB1)
SIM_VPP(UNUSED): SIMVPP.1, U7.CARD_VPP_PIN6 (VPP_SIM_PIN_6)
SMARTCARD_CLOCK: JP15.30, TP22.TP, U6.76 (OC2/RD1), U7.CARD_CLK_PIN3 (CLOCK_SIM_PIN_3)
SMARTCARD_RESET: JP14.8, TP21.TP, U6.18 (AERXD0/INT1/RE8), U7.CARD_RESET_PIN2 (RESET_SIM_PIN_2)
SMARTCARD_RX_PIC_TX: JP14.31, R26.1, U6.53 (SCL1A/SDO1A/U1ATX/RF8)
SMARTCARD_TX_PIC_RX: JP14.30, R26.2, TP23.TP, U6.52 (SDA1A/SDI1A/U1ARX/RF2), U7.CARD_IO_PIN7 (I/O_SIM_PIN_7)
SMARTCARD_VCC: JP14.16, TP20.TP, U6.33 (AN9/C2OUT/RB9), U7.CARD_VCC_PIN1 (VCC_SIM_PIN_1)
SMART_CARD_DETECT: JP16.8, U6.25 (PGED1/AN0/CN2/RB0)
UPS_ORIN1: JP9.1, R43.1, TP8.TP, U2.6 (1Y), U3.1 (A)
USBID: R23.2, TP32.TP, U6.51 (USBID/RF3), U$2.ID ($USBID)
USB_D+: TP31.TP, U6.57 (D+/RG2), U$2.D+ ($D+)
USB_D-: TP30.TP, U6.56 (D-/RG3), U$2.D- ($D-)
USB_LED_GREEN: JP15.9, LED8.C, U6.99 (PMD3/RE3)
USER_BUTTON: JP15.5, R30.2, U6.4 (PMD6/RE6), USER.3, USER.4
USER_LED_YELLOW: JP14.37, LED3.C, U6.67 (AETXEN/SDA1/INT4/RA15)
VBUS: C25.2, C26.1, C27.1, C28.1, C29.1, C30.1, F1.1, JP14.39, JP15.39, R3.3 (E), R4.3 (E), R8.1, R11.1, R12.1, R39.2, R41.1, U1.7 (P1A), U1.8 (P0A), U1.14 (VDD), U2.5 (VCC), U3.5 (VDD), U4.4 (V+), U5.14 (VCC), U6.54 (VBUS), U8.P$3 (IN)
VCAP/VDDCORE: C15.1, C16.1, U6.85 (VCAP/VDDCORE)
VDIVBIAS: C1.1, R1.1, R8.2, R10.1
WIEGAND_0_IN: JP15.24, TP34.TP, U6.82 (PMRD/CN14/RD5)
WIEGAND_0_OUT: JP15.28, TP33.TP, U6.78 (OC4/RD3)
WIEGAND_1_IN: JP15.23, TP35.TP, U6.83 (ETXEN/PMD14/CN15/RD6)
WIEGAND_1_OUT: JP15.29, TP29.TP, U6.77 (OC3/RD2)

Notes on the sheet:
PF!!!!
Bad Joints On These Capacitors Will Prevent PIC From Running !!!
Tight tolerances on these caps
DNF
For alignment pins

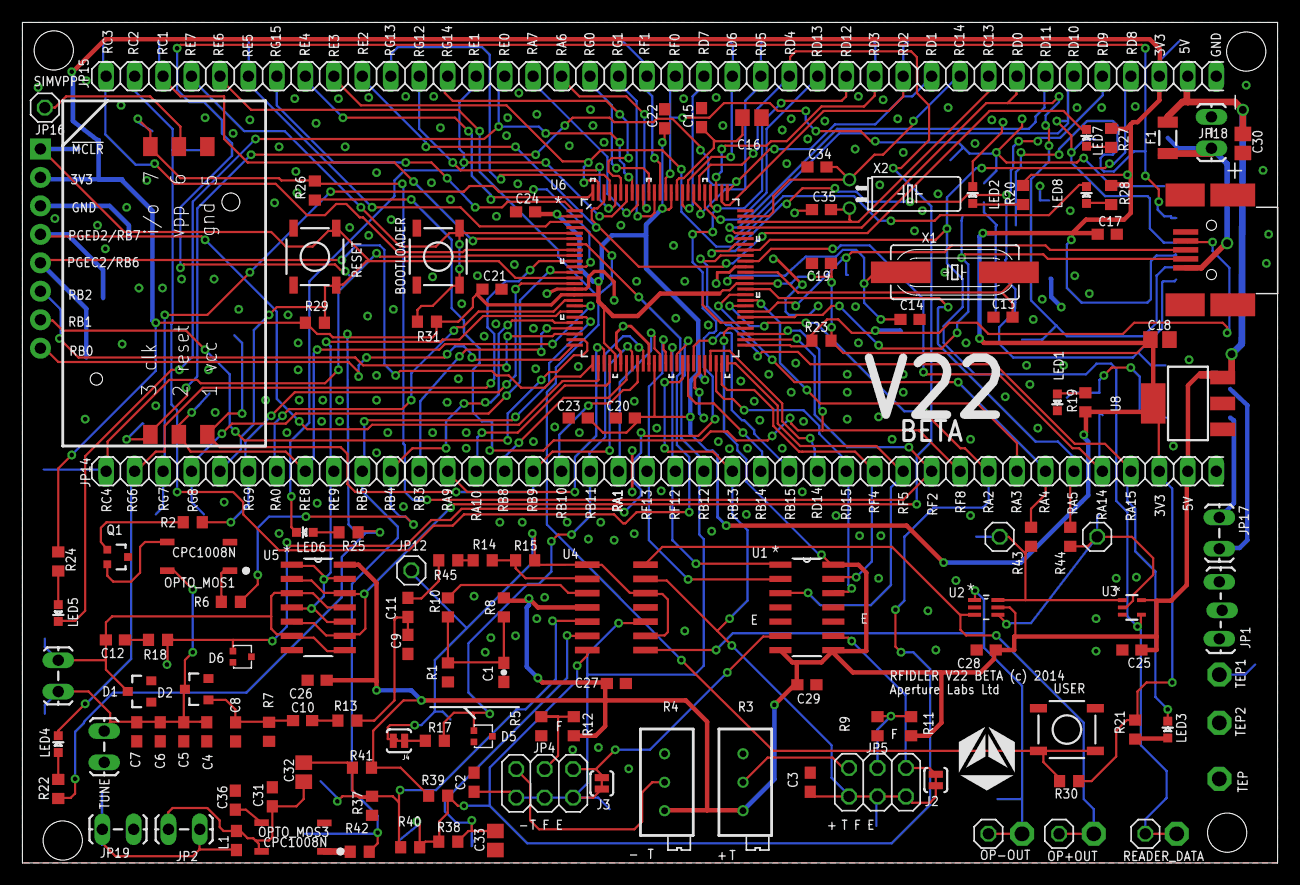
[picture p20: board RFIDLER V22 beta.brd from above]

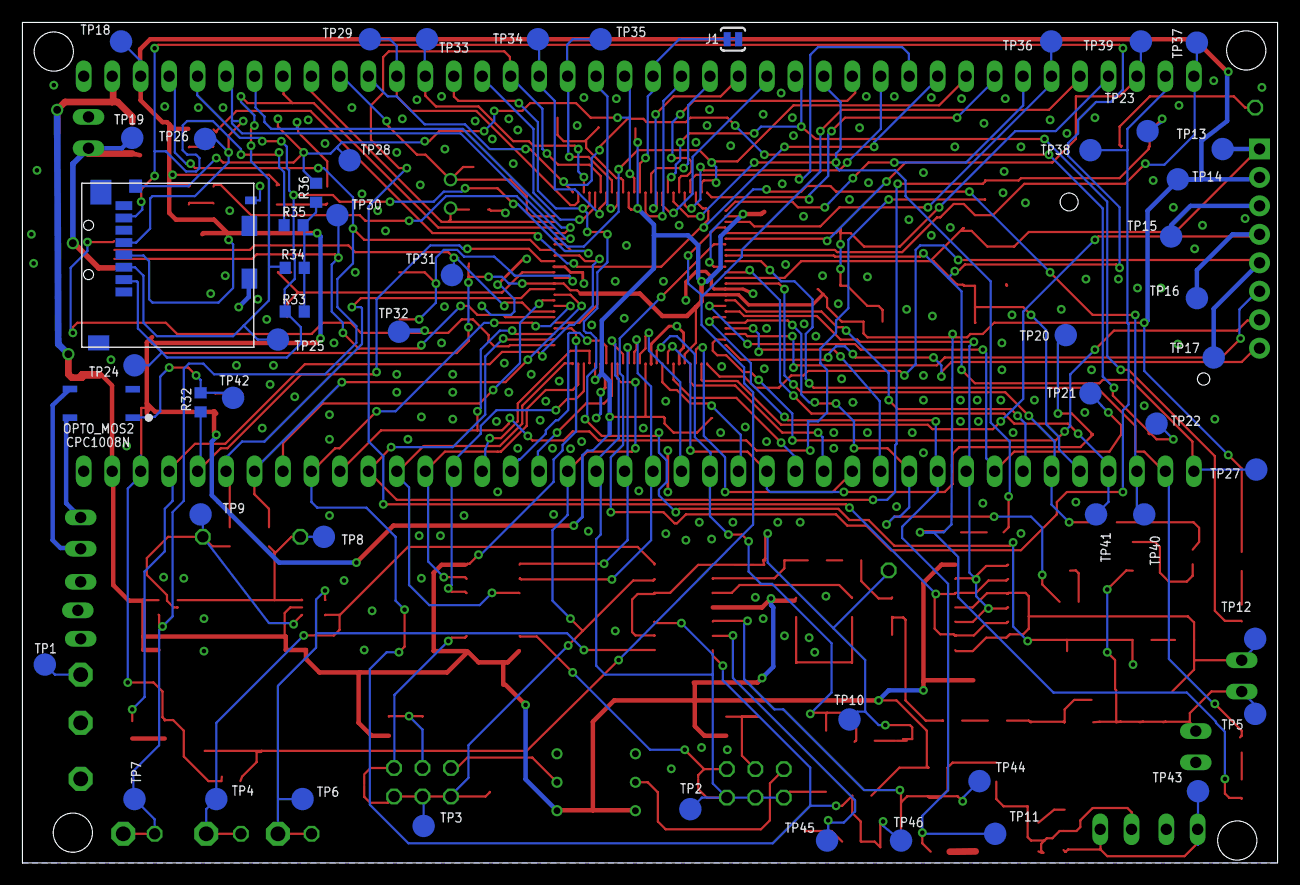
[picture p21: board RFIDLER V22 beta.brd from below]

Board: 2 copper layers, 112.0 x 75.0 mm, 193 parts (58 on the bottom side), 133 nets.

Other parts of the board:
U$1: AP_LOGO_5MM_SILK
