AdamLaurie/RFIDler/firmware/Pic32/RFIDler.X/src/tags.c

/*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
   *
 * As another special exception to the GPL terms, Aperture Labs Ltd. grants*
 * permission to link the code of this program with any version of the     *
 * OpenSSL library which is distributed under a license identical to that  *
 * listed in the included docs/licenses/OpenSSL.txt file, and distribute   *
 * linked combinations including the two.                                  *
 *                                                                         *
 * Any redistribution of Covered Software, including any derived works,    *
 * must obey and carry forward all of the terms of this license, including *
 * obeying all GPL rules and restrictions.  For example, source code of    *
 * the whole work must be provided and free redistribution must be         *
 * allowed.  All GPL references to "this License", are to be treated as    *
 * including the terms and conditions of this license text as well.        *
 *                                                                         *
 * Because this license imposes special exceptions to the GPL, Covered     *
 * Work may not be combined (even as part of a larger work) with plain GPL *
 * software.  The terms, conditions, and exceptions of this license must   *
 * be included as well.  This license is incompatible with some other open *
 * source licenses as well.  In some cases we can relicense portions of    *
 * RFIDler or grant special permissions to use it in other open source     *
 * software.  Please contact sales@aperturelabs.com with any such requests.*
 * Similarly, we don't incorporate incompatible open source software into  *
 * Covered Software without special permission from the copyright holders. *
 *                                                                         *
 * If you have any questions about the licensing restrictions on using     *
 * RFIDler in other works, are happy to help.  As mentioned above, we also *
 * offer alternative license to integrate RFIDler into proprietary         *
 * applications and appliances.  These contracts have been sold to dozens  *
 * of software vendors, and generally include a perpetual license as well  *
 * as providing for priority support and updates.  They also fund the      *
 * continued development of RFIDler.  Please email sales@aperturelabs.com  *
 * for further information.                                                *
 * If you have received a written license agreement or contract for        *
 * Covered Software stating terms other than these, you may choose to use  *
 * and redistribute Covered Software under those terms instead of these.   *
 *                                                                         *
 * Source is provided to this software because we believe users have a     *
 * right to know exactly what a program is going to do before they run it. *
 * This also allows you to audit the software for security holes (none     *
 * have been found so far).                                                *
 *                                                                         *
 * Source code also allows you to port RFIDler to new platforms, fix bugs, *
 * and add new features.  You are highly encouraged to send your changes   *
 * to the RFIDler mailing list for possible incorporation into the         *
 * main distribution.  By sending these changes to Aperture Labs Ltd. or   *
 * one of the Aperture Labs Ltd. development mailing lists, or checking    *
 * them into the RFIDler source code repository, it is understood (unless  *
 * you specify otherwise) that you are offering the RFIDler Project        *
 * (Aperture Labs Ltd.) the unlimited, non-exclusive right to reuse,       *
 * modify, and relicense the code.  RFIDler will always be available Open  *
 * Source, but this is important because the inability to relicense code   *
 * has caused devastating problems for other Free Software projects (such  *
 * as KDE and NASM).  We also occasionally relicense the code to third     *
 * parties as discussed above. If you wish to specify special license      *
 * conditions of your contributions, just say so when you send them.       *
 *                                                                         *
 * This program is distributed in the hope that it will be useful, but     *
 * WITHOUT ANY WARRANTY; without even the implied warranty of              *
 * MERCHANTABILITY or FITNESS FOR A PARTICULAR PURPOSE.  See the RFIDler   *
 * license file for more details (it's in a COPYING file included with     *
 * RFIDler, and also available from                                        *
 *   https://github.com/ApertureLabsLtd/RFIDler/COPYING                    *
 *                                                                         *
 ***************************************************************************/

// Author: Adam Laurie <adam@aperturelabs.com>


#include "HardwareProfile.h"

#include "awid.h"
#include "clock.h"
#include "comms.h"
#include "em.h"
#include "fdxb.h"
#include "hdx.h"
#include "hitag.h"
#include "hid.h"
#include "indala.h"
#include "q5.h"
#include "rfidler.h"
#include "t55x7.h"
#include "tags.h"
#include "uid.h"
#include "unique.h"
#include "paxton.h"
#include "util.h"
#include "write.h"

// tagtype #defines in rfidler.h
const BYTE *TagTypes[]= {
    "NONE",
    "ASKRAW",
    "FSK1RAW",
    "FSK2RAW",
    "PSK1RAW",
    "PSK2RAW",
    "PSK3RAW",
    "HITAG1",
    "HITAG2",
    "EM4X02",
    "Q5",
    "HID26",
    "INDALA64",
    "INDALA224",
    "UNIQUE",
    "FDXB",
    "T55X7",
    "AWID26",
    "EM4X05",
    "TAMAGOTCHI",
    "HDX",
    "PAXTON",
    NULL
};

// see rfidler.h for #defined constants
const BYTE *ModulationSchemes[] = {
    "None",
    "ASK/OOK",
    "FSK",
    "FSK",
    "PSK",
    "PSK",
    "PSK",
    NULL
};

void tag_list(void)
{
    unsigned char i;

    UserMessage("%s", "\r\nKnown TAG types:\r\n");
    for(i= 1 ; TagTypes[i] != NULL ; ++i)
    {
        UserMessage("\r\n  %s", (BYTE *) TagTypes[i]);
    }
    UserMessage("%s", "\r\n");
}

BYTE tag_get_type(BYTE *tag)
{
    BYTE i;

    for(i= 0 ; TagTypes[i] != NULL ; ++i)
        if(strcmp(tag, TagTypes[i]) == 0)
            return i;
    return 0;
}

unsigned int tag_get_blocksize(BYTE tag)
{
    switch(tag)
    {
        // raw tag types return blocksize of emulator tag
        case TAG_TYPE_ASK_RAW:
        case TAG_TYPE_FSK1_RAW:
        case TAG_TYPE_FSK2_RAW:
        case TAG_TYPE_PSK1_RAW:
        case TAG_TYPE_PSK2_RAW:
        case TAG_TYPE_PSK3_RAW:
            return tag_get_blocksize(RFIDlerVTag.TagType);

        case TAG_TYPE_EM4X05:
            return EM4X05_BLOCKSIZE;

        case TAG_TYPE_HITAG1:
            return HITAG1_BLOCKSIZE;

        case TAG_TYPE_HITAG2:
            return HITAG2_BLOCKSIZE;

        case TAG_TYPE_Q5:
            return Q5_BLOCKSIZE;

        case TAG_TYPE_T55X7:
            return T55X7_BLOCKSIZE;

        default:
            return 0;
    }
}

unsigned int tag_get_datablocks(BYTE tag)
{
    switch(tag)
    {
        // raw tag types return number of blocks needed for emulator tag type
        case TAG_TYPE_ASK_RAW:
        case TAG_TYPE_FSK1_RAW:
        case TAG_TYPE_FSK2_RAW:
        case TAG_TYPE_PSK1_RAW:
        case TAG_TYPE_PSK2_RAW:
        case TAG_TYPE_PSK3_RAW:
            return RFIDlerConfig.DataBits / tag_get_blocksize(RFIDlerVTag.TagType);

        case TAG_TYPE_EM4X05:
            return EM4X05_DATABLOCKS;

       case TAG_TYPE_HITAG1:
            return HITAG1_DATABLOCKS;

        case TAG_TYPE_HITAG2:
            return HITAG2_DATABLOCKS;

        case TAG_TYPE_Q5:
            return Q5_DATABLOCKS;

        case TAG_TYPE_T55X7:
            return T55X7_DATABLOCKS;

        default:
            return 0;
    }
}

unsigned int tag_get_databits(BYTE tag)
{
    switch(tag)
    {
        case TAG_TYPE_ASK_RAW:
        case TAG_TYPE_FSK1_RAW:
        case TAG_TYPE_FSK2_RAW:
        case TAG_TYPE_PSK1_RAW:
        case TAG_TYPE_PSK2_RAW:
        case TAG_TYPE_PSK3_RAW:
            return RAW_TAGS_DATABITS;

        case TAG_TYPE_EM4X02:
            return EM4X02_DATABITS;

        case TAG_TYPE_EM4X05:
            return EM4X05_DATABLOCKS * EM4X05_BLOCKSIZE;
            
        case TAG_TYPE_HID_26:
            return HID26_DATABITS;

        case TAG_TYPE_AWID_26:
            return AWID26_DATABITS;

        case TAG_TYPE_FDXB:
            return FDXB_DATABITS;

        case TAG_TYPE_HDX:
            return HDX_DATABITS;

        case TAG_TYPE_HITAG1:
            return HITAG1_DATABLOCKS * HITAG1_BLOCKSIZE;

        case TAG_TYPE_HITAG2:
            return HITAG2_DATABLOCKS * HITAG2_BLOCKSIZE;

        case TAG_TYPE_INDALA_64:
            return INDALA_64_DATABITS;

        case TAG_TYPE_INDALA_224:
            return INDALA_224_DATABITS;

        case TAG_TYPE_Q5:
            return Q5_DATABLOCKS * Q5_BLOCKSIZE;

        case TAG_TYPE_T55X7:
            return T55X7_DATABLOCKS * T55X7_BLOCKSIZE;

        case TAG_TYPE_UNIQUE:
            return UNIQUE_DATABITS;
            
        case TAG_TYPE_PAXTON:
            return PAXTON_DATABITS;

        default:
            return 0;
    }
}

BYTE auto_detect_tag_type(void)
{
    BYTE i, tag, tmp[MAXUID + 1];

    tag= RFIDlerConfig.TagType;

    UserMessage("%s", "\r\n");
    for(i= 1 ; TagTypes[i] != NULL ; ++i)
    {
        UserMessage("\r\n  %s: ", (BYTE *) TagTypes[i]);
        tag_set(i);
        if(get_interpreted_tag_uid(tmp, RFIDlerConfig.TagType))
            UserMessage("%s", tmp);
    }
    tag_set(tag);
    UserMessage("%s", "\r\n");
}

BOOL tag_set(BYTE tag)
{
    // reset everything, then set what needs to be changed
    // most timings are in FCs unless otherwise specified
    // FrameClock itself is in us/100 (i.e. 800 is 8us == 125KHz)
    // Timeout is in us
    RFIDlerConfig.FrameClock= 0;
    RFIDlerConfig.BiPhase= FALSE;
    RFIDlerConfig.Manchester= FALSE;
    RFIDlerConfig.HalfDuplex= FALSE;
    RFIDlerConfig.Invert= FALSE;
    RFIDlerConfig.Modulation= MOD_MODE_NONE;
    RFIDlerConfig.PotLow= 0;
    RFIDlerConfig.PotHigh= 0;
    RFIDlerConfig.DataRate= 0;
    RFIDlerConfig.DataRateSub0= 0;
    RFIDlerConfig.DataRateSub1= 0;
    RFIDlerConfig.DataBits= 0;
    RFIDlerConfig.TagType= tag;
    RFIDlerConfig.Repeat= 0;
    RFIDlerConfig.Timeout= 0L;
    RFIDlerConfig.Sync[0]= 0x00;
    RFIDlerConfig.Sync[1]= 0x00;
    RFIDlerConfig.Sync[2]= 0x00;
    RFIDlerConfig.Sync[3]= 0x00;
    RFIDlerConfig.SyncBits= 0;
    RFIDlerConfig.RWD_Gap_Period= 0;
    RFIDlerConfig.RWD_Sleep_Period= 0;
    RFIDlerConfig.RWD_Wake_Period= 0;
    RFIDlerConfig.RWD_Zero_Period= 0;
    RFIDlerConfig.RWD_One_Period= 0;
    RFIDlerConfig.RWD_Wait_Switch_RX_TX= 0;
    RFIDlerConfig.RWD_Wait_Switch_TX_RX= 0;

    switch(tag)
    {
        case TAG_TYPE_NONE:
            break;

        case TAG_TYPE_ASK_RAW:
            RFIDlerConfig.FrameClock= 800; // 125 KHz
            RFIDlerConfig.Modulation= MOD_MODE_ASK_OOK;
            RFIDlerConfig.PotHigh= 100;
            RFIDlerConfig.DataRate= 32;
            RFIDlerConfig.DataBits= RAW_TAGS_DATABITS;
            RFIDlerConfig.TagType= tag;
            RFIDlerConfig.Repeat= 20;
            RFIDlerConfig.Timeout= 13000; // timeout in uS (note with prescaler of 16 max is 13107)
            RFIDlerConfig.RWD_Wake_Period= 1000;
            break;

      case TAG_TYPE_AWID_26:
            //RFIDlerConfig.FrameClock= 765; // 130.7 KHz (134KHz breaks emulation)
            RFIDlerConfig.FrameClock= 800; // 125 KHz
            RFIDlerConfig.Modulation= MOD_MODE_FSK2;
            RFIDlerConfig.PotHigh=  110;
            RFIDlerConfig.DataRate= 50;
            RFIDlerConfig.DataRateSub0= 8;
            RFIDlerConfig.DataRateSub1= 10;
            RFIDlerConfig.DataBits= 96;
            RFIDlerConfig.TagType= tag;
            RFIDlerConfig.Repeat= 20;
            RFIDlerConfig.Timeout= 13000; // timeout in uS (note with prescaler of 16 max is 13107)
            RFIDlerConfig.Sync[0]= 0x01;
            RFIDlerConfig.Sync[1]= 0x1D;
            RFIDlerConfig.Sync[2]= 0x80;
            RFIDlerConfig.Sync[3]= 0x00;
            RFIDlerConfig.SyncBits= 18;
            RFIDlerConfig.RWD_Wake_Period= 1000;
            break;
              
        case TAG_TYPE_EM4X02:
        case TAG_TYPE_UNIQUE:
        case TAG_TYPE_PAXTON:
            RFIDlerConfig.FrameClock= 800;
            RFIDlerConfig.Manchester= TRUE;
            RFIDlerConfig.Modulation= MOD_MODE_ASK_OOK;
            RFIDlerConfig.PotHigh= 150;
            RFIDlerConfig.DataRate= 64;
            RFIDlerConfig.DataBits= 64;
            RFIDlerConfig.TagType= tag;
            RFIDlerConfig.Repeat= 20;
            RFIDlerConfig.Timeout= 13000; // timeout in uS (note with prescaler of 16 max is 13107)
            RFIDlerConfig.Sync[0]= 0xFF;
            RFIDlerConfig.Sync[1]= 0xFF;
            RFIDlerConfig.Sync[2]= 0x00;
            RFIDlerConfig.Sync[3]= 0x00;
            RFIDlerConfig.SyncBits= 9;
            RFIDlerConfig.RWD_Wake_Period= 1000;
            break;

        // DEBUG: work in progress!
        case TAG_TYPE_EM4X05:
            RFIDlerConfig.FrameClock= 800; // 125 KHz
            RFIDlerConfig.Manchester= TRUE;
            RFIDlerConfig.Modulation= MOD_MODE_ASK_OOK;
            RFIDlerConfig.PotHigh= 130;
            RFIDlerConfig.DataRate= 64;
            RFIDlerConfig.DataBits= 53; // 45 bit OTA format + 8 bit preamble
            RFIDlerConfig.DataBlocks= EM4X05_DATABLOCKS;
            RFIDlerConfig.BlockSize= EM4X05_BLOCKSIZE;
            RFIDlerConfig.TagType= tag;
            RFIDlerConfig.Repeat= 20;
            RFIDlerConfig.Timeout= 13000; // timeout in uS (note with prescaler of 16 max is 13107)
            RFIDlerConfig.RWD_Wake_Period= 1000; // docco says max 3 ms, but round up a bit
            RFIDlerConfig.RWD_Gap_Period= 55; // First Field Stop
            RFIDlerConfig.RWD_Sleep_Period= 2000;
            RFIDlerConfig.RWD_Zero_Period= 16; // note that em4x05 uses it's own PWM scheme
            RFIDlerConfig.RWD_One_Period= 32; // see em.c for details
            RFIDlerConfig.RWD_Wait_Switch_TX_RX= 60; // doc says 544us, (9.34 + 1.38 ms when eeprom write), but tests are much shorter!
            RFIDlerConfig.RWD_Wait_Switch_RX_TX= 80; // docs say 544, so about 68 fcs
            break;

       case TAG_TYPE_FDXB:
            RFIDlerConfig.FrameClock= 745; // 134.2 KHz
            RFIDlerConfig.BiPhase= TRUE;
            RFIDlerConfig.Invert= TRUE;
            RFIDlerConfig.Modulation= MOD_MODE_ASK_OOK;
            RFIDlerConfig.PotHigh= 130;
            RFIDlerConfig.DataRate= 32;
            RFIDlerConfig.DataBits= 128;
            RFIDlerConfig.TagType= tag;
            RFIDlerConfig.Repeat= 20;
            RFIDlerConfig.Timeout= 13000; // timeout in uS (note with prescaler of 16 max is 13107)
            RFIDlerConfig.Sync[0]= 0x00;
            RFIDlerConfig.Sync[1]= 0x20;
            RFIDlerConfig.Sync[2]= 0x00;
            RFIDlerConfig.Sync[3]= 0x00;
            RFIDlerConfig.SyncBits= 11;
            RFIDlerConfig.RWD_Wake_Period= 1000;
            break;

       case TAG_TYPE_FSK1_RAW:
            RFIDlerConfig.FrameClock= 800;
            RFIDlerConfig.Modulation= MOD_MODE_FSK1;
            RFIDlerConfig.PotHigh= POTHIGH_DEFAULT;
            RFIDlerConfig.DataRate= 50;
            RFIDlerConfig.DataRateSub0= 8;
            RFIDlerConfig.DataRateSub1= 5;
            RFIDlerConfig.DataBits= RAW_TAGS_DATABITS;
            RFIDlerConfig.TagType= tag;
            RFIDlerConfig.Repeat= 20;
            RFIDlerConfig.Timeout= 13000; // timeout in uS (note with prescaler of 16 max is 13107)
            RFIDlerConfig.RWD_Wake_Period= 1000;
            break;

       case TAG_TYPE_FSK2_RAW:
            RFIDlerConfig.FrameClock= 800;
            RFIDlerConfig.Modulation= MOD_MODE_FSK2;
            RFIDlerConfig.PotHigh= 90;
            RFIDlerConfig.DataRate= 50;
            RFIDlerConfig.DataRateSub0= 8;
            RFIDlerConfig.DataRateSub1= 10;
            RFIDlerConfig.DataBits= RAW_TAGS_DATABITS;
            RFIDlerConfig.TagType= tag;
            RFIDlerConfig.Repeat= 20;
            RFIDlerConfig.Timeout= 13000; // timeout in uS (note with prescaler of 16 max is 13107)
            RFIDlerConfig.RWD_Wake_Period= 1000;
            break;
                  
        case TAG_TYPE_HID_26:
            //RFIDlerConfig.FrameClock= 765; // 130.7 KHz (134KHz breaks emulation)
            RFIDlerConfig.FrameClock= 800; // 125 KHz
            RFIDlerConfig.Modulation= MOD_MODE_FSK2;
            RFIDlerConfig.PotHigh=  110;
            RFIDlerConfig.DataRate= 50;
            RFIDlerConfig.DataRateSub0= 8;
            RFIDlerConfig.DataRateSub1= 10;
            RFIDlerConfig.DataBits= 96;
            RFIDlerConfig.TagType= tag;
            RFIDlerConfig.Repeat= 20;
            RFIDlerConfig.Timeout= 13000; // timeout in uS (note with prescaler of 16 max is 13107)
            RFIDlerConfig.Sync[0]= 0x1D;
            RFIDlerConfig.Sync[1]= 0x55;
            RFIDlerConfig.Sync[2]= 0x00;
            RFIDlerConfig.Sync[3]= 0x00;
            RFIDlerConfig.SyncBits= 16;
            RFIDlerConfig.RWD_Wake_Period= 1000;
            break;

        case TAG_TYPE_HITAG1:
            RFIDlerConfig.FrameClock= 800;
            RFIDlerConfig.Manchester= TRUE;
            RFIDlerConfig.Modulation= MOD_MODE_ASK_OOK;
            RFIDlerConfig.PotHigh= 170;
            RFIDlerConfig.DataRate= 32;
            RFIDlerConfig.DataBits= 33; //
            RFIDlerConfig.DataBlocks= HITAG1_DATABLOCKS;
            RFIDlerConfig.BlockSize= HITAG1_BLOCKSIZE;
            RFIDlerConfig.TagType= tag;
            RFIDlerConfig.Repeat= 20;
            RFIDlerConfig.Timeout= 13000; // timeout in uS (note with prescaler of 16 max is 13107)
            RFIDlerConfig.RWD_Gap_Period= 4; // 4 - 10
            RFIDlerConfig.RWD_Sleep_Period= 2000;
            RFIDlerConfig.RWD_Wake_Period= 500; // documentations says ~3ms, so round up a bit
            RFIDlerConfig.RWD_Zero_Period= 18; // 18 - 22
            RFIDlerConfig.RWD_One_Period= 26; // 26 - 32
            RFIDlerConfig.RWD_Wait_Switch_TX_RX= 180; // docs say 204, so stop a little earlier so we catch leading edge
            RFIDlerConfig.RWD_Wait_Switch_RX_TX= 120; // docs say 96, so give it a bit longer t0 be safe!
            RFIDlerConfig.SyncBits= 0;
            RFIDlerConfig.Sync[0]= 0x00;
            RFIDlerConfig.Sync[0]= 0x00;
            RFIDlerConfig.Sync[0]= 0x00;
            RFIDlerConfig.Sync[0]= 0x00;
            break;

        case TAG_TYPE_HITAG2:
            RFIDlerConfig.FrameClock= 800;
            RFIDlerConfig.Manchester= TRUE;
            RFIDlerConfig.Modulation= MOD_MODE_ASK_OOK;
            RFIDlerConfig.PotHigh= 160;
            RFIDlerConfig.DataRate= 32;
            RFIDlerConfig.DataBits= 37; // 5 bits leadin + 32 bits ID
            RFIDlerConfig.DataBlocks= HITAG2_DATABLOCKS;
            RFIDlerConfig.BlockSize= HITAG2_BLOCKSIZE;
            RFIDlerConfig.TagType= tag;
            RFIDlerConfig.Repeat= 20;
            RFIDlerConfig.Timeout= 13000; // timeout in uS (note with prescaler of 16 max is 13107)
            RFIDlerConfig.RWD_Gap_Period= 3; // 4 - 10 (we use 3 to allow for sloppiness in RWD timings)
            RFIDlerConfig.RWD_Sleep_Period= 2000;  // 2000;
            RFIDlerConfig.RWD_Wake_Period= 525; // (was 450) must be > 312.5 but less than 544 to allow reset of user modes
            RFIDlerConfig.RWD_Zero_Period= 18; // 18 - 22
            RFIDlerConfig.RWD_One_Period= 26; // 26 - 32
            RFIDlerConfig.RWD_Wait_Switch_TX_RX= 150; // docs say 199 - 206 but in practice it can be less
            RFIDlerConfig.RWD_Wait_Switch_RX_TX= 90;
            RFIDlerConfig.Sync[0]= 0xF8;
            RFIDlerConfig.Sync[1]= 0x00;
            RFIDlerConfig.Sync[2]= 0x00;
            RFIDlerConfig.Sync[3]= 0x00;
            RFIDlerConfig.SyncBits= 5;
            break;

        case TAG_TYPE_INDALA_64:
            RFIDlerConfig.FrameClock= 800;
            RFIDlerConfig.Modulation= MOD_MODE_PSK1;
            RFIDlerConfig.PotLow= POTLOW_DEFAULT;
            RFIDlerConfig.PotHigh= 170;
            RFIDlerConfig.DataRate= 32;
            RFIDlerConfig.DataRateSub0= 2;
            RFIDlerConfig.DataBits= 64;
            RFIDlerConfig.TagType= tag;
            RFIDlerConfig.Repeat= 20;
            RFIDlerConfig.Timeout= 13000; // timeout in uS (note with prescaler of 16 max is 13107)
            RFIDlerConfig.PSK_Quality= 4L;
            RFIDlerConfig.Sync[0]= 0x00;
            RFIDlerConfig.Sync[1]= 0x00;
            RFIDlerConfig.Sync[2]= 0x00;
            RFIDlerConfig.Sync[3]= 0x00;
            RFIDlerConfig.SyncBits= 24;
            RFIDlerConfig.RWD_Wake_Period= 1000;
            break;

        case TAG_TYPE_INDALA_224:
            RFIDlerConfig.FrameClock= 800;
            RFIDlerConfig.Modulation= MOD_MODE_PSK1;
            RFIDlerConfig.PotLow= POTLOW_DEFAULT;
            RFIDlerConfig.PotHigh= 170;
            RFIDlerConfig.DataRate= 32;
            RFIDlerConfig.DataRateSub0= 2;
            RFIDlerConfig.DataBits= 224;
            RFIDlerConfig.TagType= tag;
            RFIDlerConfig.Repeat= 20;
            RFIDlerConfig.Timeout= 13000; // timeout in uS (note with prescaler of 16 max is 13107)
            RFIDlerConfig.PSK_Quality= 4L;
            RFIDlerConfig.Sync[0]= 0x00;
            RFIDlerConfig.Sync[1]= 0x00;
            RFIDlerConfig.Sync[2]= 0x00;
            RFIDlerConfig.Sync[3]= 0x00;
            RFIDlerConfig.SyncBits= 24;
            RFIDlerConfig.RWD_Wake_Period= 1000;
            break;

        case TAG_TYPE_PSK1_RAW:
            RFIDlerConfig.FrameClock= 800;
            RFIDlerConfig.Modulation= MOD_MODE_PSK1;
            RFIDlerConfig.PotLow= POTLOW_DEFAULT;
            RFIDlerConfig.PotHigh= POTHIGH_DEFAULT;
            RFIDlerConfig.DataRate= 32;
            RFIDlerConfig.DataRateSub0= 2;
            RFIDlerConfig.DataBits= RAW_TAGS_DATABITS;
            RFIDlerConfig.TagType= tag;
            RFIDlerConfig.Repeat= 20;
            RFIDlerConfig.Timeout= 13000; // timeout in uS (note with prescaler of 16 max is 13107)
            RFIDlerConfig.PSK_Quality= 4L;
            RFIDlerConfig.RWD_Wake_Period= 1000;
            break;

        case TAG_TYPE_Q5:
            RFIDlerConfig.FrameClock= 800;
            RFIDlerConfig.Manchester= TRUE;
            RFIDlerConfig.Modulation= MOD_MODE_ASK_OOK;
            RFIDlerConfig.PotHigh= 160;
            RFIDlerConfig.DataRate= 64;
            RFIDlerConfig.DataBits= 64;
            RFIDlerConfig.DataBlocks= Q5_DATABLOCKS;
            RFIDlerConfig.BlockSize= Q5_BLOCKSIZE;
            RFIDlerConfig.TagType= tag;
            RFIDlerConfig.Repeat= 20;
            RFIDlerConfig.Timeout= 13000; // timeout in uS (note with prescaler of 16 max is 13107)
            RFIDlerConfig.Sync[0]= 0xFF;
            RFIDlerConfig.Sync[1]= 0xFF;
            RFIDlerConfig.Sync[2]= 0x00;
            RFIDlerConfig.Sync[3]= 0x00;
            RFIDlerConfig.SyncBits= 9;
            RFIDlerConfig.RWD_Sleep_Period= 13000;
            RFIDlerConfig.RWD_Wake_Period= 4000; // must be more than 3ms, but play it safe
            RFIDlerConfig.RWD_Gap_Period= 50; // 14 nominal, 8 - 50 normal, 8 - 25 fast write mode
            RFIDlerConfig.RWD_Zero_Period= 16; //24; // 24 nominal, 16 - 31 normal, 8 - 15 fast write mode
            RFIDlerConfig.RWD_One_Period= 48; //54; // 54 nominal, 48 - 63 normal, 24 - 31 fast write mode
            RFIDlerConfig.RWD_Wait_Switch_TX_RX= 48; //64; // q5 will exit downlink mode after 64 but may not yet be damped!
            RFIDlerConfig.RWD_Wait_Switch_RX_TX= 192; // the longer the better!
            PWD_Mode= FALSE;
            break;

        case TAG_TYPE_T55X7:
            RFIDlerConfig.FrameClock= 800;
            RFIDlerConfig.Modulation= MOD_MODE_ASK_OOK;
            RFIDlerConfig.PotHigh= POTHIGH_DEFAULT;
            RFIDlerConfig.Manchester= TRUE;
            RFIDlerConfig.DataRate= 32;
            RFIDlerConfig.DataBits= 64;
            RFIDlerConfig.Sync[0]= 0xE0;
            RFIDlerConfig.Sync[1]= 0x15;
            RFIDlerConfig.Sync[2]= 0x00;
            RFIDlerConfig.Sync[3]= 0x00;
            RFIDlerConfig.SyncBits= 16;
            RFIDlerConfig.DataBlocks= T55X7_DATABLOCKS;
            RFIDlerConfig.BlockSize= T55X7_BLOCKSIZE;
            RFIDlerConfig.TagType= tag;
            RFIDlerConfig.Repeat= 20;
            RFIDlerConfig.Timeout= 13000; // timeout in uS (note with prescaler of 16 max is 13107)
            RFIDlerConfig.RWD_Sleep_Period= 13000; // small tags such as keyfobs need a long sleep to reset
            RFIDlerConfig.RWD_Wake_Period= 4000;
            RFIDlerConfig.RWD_Gap_Period= 23; // 14; // 14 nominal, 8 - 30 normal, 8 - 25 fast write mode
            RFIDlerConfig.RWD_Zero_Period= 16; // 24; // 24 nominal, 16 - 31 normal, 8 - 15 fast write mode
            RFIDlerConfig.RWD_One_Period= 48; // 54; // 54 nominal, 48 - 63 normal, 24 - 31 fast write mode
            RFIDlerConfig.RWD_Wait_Switch_TX_RX= 64; // t55x7 will exit downlink mode after 64 but we mustn't read until t55x7 switches damping on
            RFIDlerConfig.RWD_Wait_Switch_RX_TX= 192;
            break;
            
        // special case - TAMAGOTCHI do not do anything but PWM, so most settings are irrelevant
        case TAG_TYPE_TAMAGOTCHI:
            RFIDlerConfig.FrameClock= 800;
            RFIDlerConfig.TagType= tag;
            RFIDlerConfig.Repeat= 20;
            RFIDlerConfig.Timeout= 13000; // timeout in uS (note with prescaler of 16 max is 13107)
            RFIDlerConfig.RWD_Sleep_Period= 13000; // small tags such as keyfobs need a long sleep to reset
            RFIDlerConfig.RWD_Wake_Period= 4000;
            RFIDlerConfig.RWD_Gap_Period= 23; // 14; // 14 nominal, 8 - 30 normal, 8 - 25 fast write mode
            RFIDlerConfig.RWD_Zero_Period= 16; // 24; // 24 nominal, 16 - 31 normal, 8 - 15 fast write mode
            RFIDlerConfig.RWD_One_Period= 48; // 54; // 54 nominal, 48 - 63 normal, 24 - 31 fast write mode
            RFIDlerConfig.RWD_Wait_Switch_TX_RX= 64; // t55x7 will exit downlink mode after 64 but we mustn't read until t55x7 switches damping on
            RFIDlerConfig.RWD_Wait_Switch_RX_TX= 192;
            break;

        default:
            return FALSE;
    }

    // stop clocks
    stop_HW_clock();

    // configure potentiometers
    set_mcp414_wiper(WIPER_HIGH, VOLATILE, RFIDlerConfig.PotHigh, TmpBuff);
    set_mcp414_wiper(WIPER_LOW, VOLATILE, RFIDlerConfig.PotLow, TmpBuff);

    // delay to allow things to settle
    Delay_us(500000);

    // reset globals
    PWD_Mode= FALSE;
    memset(Password, '\0', sizeof(Password));
    
    return TRUE;
}

// encode UID to raw hex according to TAG selection
BOOL tag_uid_to_hex(BYTE *hex, BYTE *uid, BYTE tagtype)
{
    switch(tagtype)
    {
        case TAG_TYPE_ASK_RAW:
        case TAG_TYPE_EM4X05:
        case TAG_TYPE_FSK1_RAW:
        case TAG_TYPE_FSK2_RAW:
        case TAG_TYPE_PSK1_RAW:
        case TAG_TYPE_PSK2_RAW:
        case TAG_TYPE_PSK3_RAW:
            memcpy(hex, uid, strlen(uid));
            return TRUE;

        case TAG_TYPE_AWID_26:
            if(!bcd_to_awid26_hex(hex, uid))
                return FALSE;
            return TRUE;
            
        case TAG_TYPE_Q5:
        case TAG_TYPE_EM4X02:
            if(!hex_to_em4x02_hex(hex, uid))
                return FALSE;
            return TRUE;

        case TAG_TYPE_FDXB:
            if(!uid_to_fdxb_hex(hex, uid))
                return FALSE;
            return TRUE;

        case TAG_TYPE_HID_26:
            if(!bcd_to_hid26_hex(hex, uid))
                return FALSE;
            return TRUE;

        case TAG_TYPE_INDALA_64:
            if(!indala64_hex_to_uid(hex, uid))
                return FALSE;
            return TRUE;

        case TAG_TYPE_INDALA_224:
            if(!indala224_hex_to_uid(hex, uid))
                return FALSE;
            return TRUE;

        case TAG_TYPE_UNIQUE:
            if(!hex_to_unique_hex(hex, uid))
                return FALSE;
            return TRUE;
            
        case TAG_TYPE_PAXTON:
            if(!hex_to_paxton_hex(hex, uid))
                return FALSE;
            return TRUE;

        default:
            return FALSE;
    }
    return TRUE;
}

// copy raw UID to data blocks for re-transmission by target tag
void tag_raw_uid_to_data(BYTE *data, BYTE *uid, BYTE host_tagtype)
{
    BYTE            tmp[MAXUID + 1];
    unsigned int    i;
    
    switch(host_tagtype)
    {
        // EM4X05 sends everything LSB, so reverse data
        case TAG_TYPE_EM4X05:
            hextobinarray(tmp, uid);
            for(i= 0 ; i < HEXTOBITS(strlen(uid)) ; i += EM4X05_BLOCKSIZE)
                string_reverse(tmp + i, EM4X05_BLOCKSIZE);
            binarraytohex(data, tmp, HEXTOBITS(strlen(uid)));
            break;
            
        // for most tags a straight copy will do
        default:
            strcpy(data, uid);
            break;
    }
}

// reset tag to default by writing config block
BOOL tag_write_default_config(BYTE tagtype, BYTE *password)
{
    unsigned int tmp;


    if(!config_block_number(&tmp, tagtype))
        return FALSE;

    // hitag2 always needs login/auth
    if(strlen(password) || tagtype == TAG_TYPE_HITAG2)
        if(!(tag_login(tmp, TmpBuff, password) || tag_auth(tmp, TmpBuff, password)))
                return FALSE;

    // emulation block for own tag type is default config block
    if(!config_block(TmpBuff, tagtype, tagtype))
        return FALSE;
    return write_tag(tmp, TmpBuff, VERIFY);
}

// reset tag to default and wipe all data blocks
BOOL tag_write_default_blocks(BYTE tagtype, BYTE *password)
{
    unsigned int i;

    switch(tagtype)
    {
        case TAG_TYPE_EM4X05:
            if(!tag_write_default_config(tagtype, password))
                return FALSE;
            for(i= EM4X05_USER_DATA_BLOCK_NUM ; i < EM4X05_DATABLOCKS ; ++i)
                if(i != EM4X05_PW_BLOCK_NUM && !write_tag(i, EM4X05_BLANK_BLOCK, VERIFY))
                    return FALSE;
            // write default password (write only, so no verify)
            if(!write_tag(EM4X05_PW_BLOCK_NUM, EM4X05_PWD_DEFAULT, NO_VERIFY))
                return FALSE;
            return TRUE;
            
        case TAG_TYPE_HITAG2:
            if(!tag_write_default_config(tagtype, password))
                return FALSE;
            for(i= HITAG2_USER_DATA_BLOCK_NUM ; i < HITAG2_DATABLOCKS ; ++i)
                if(!write_tag(i, HITAG2_BLANK_BLOCK, VERIFY))
                    return FALSE;
            // write default password
            if(!write_tag(HITAG2_PW_BLOCK_NUM, HITAG2_PWD_DEFAULT, VERIFY))
                return FALSE;
            return TRUE;
            
        case TAG_TYPE_Q5:
            // write config first so we can verify data block writes
            if(!tag_write_default_config(tagtype, ""))
                return FALSE;
            for(i= Q5_USER_DATA_BLOCK_NUM ; i < Q5_DATABLOCKS ; ++i)
                if(!write_tag(i, Q5_BLANK_BLOCK, VERIFY))
                    return FALSE;
            return TRUE;
            
        case TAG_TYPE_T55X7:
            // write config first so we can verify data block writes
            if(!tag_write_default_config(tagtype, ""))
                return FALSE;
            for(i= T55X7_USER_DATA_BLOCK_NUM ; i < T55X7_DATABLOCKS ; ++i)
                if(!write_tag(i, T55X7_BLANK_BLOCK, VERIFY))
                    return FALSE;
            return TRUE;


        default:
            return FALSE;
    }
}
