AdamLaurie/RFIDler/firmware/Pic32/RFIDler.X/src/q5.c

/*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
   *
 * As another special exception to the GPL terms, Aperture Labs Ltd. grants*
 * permission to link the code of this program with any version of the     *
 * OpenSSL library which is distributed under a license identical to that  *
 * listed in the included docs/licenses/OpenSSL.txt file, and distribute   *
 * linked combinations including the two.                                  *
 *                                                                         *
 * Any redistribution of Covered Software, including any derived works,    *
 * must obey and carry forward all of the terms of this license, including *
 * obeying all GPL rules and restrictions.  For example, source code of    *
 * the whole work must be provided and free redistribution must be         *
 * allowed.  All GPL references to "this License", are to be treated as    *
 * including the terms and conditions of this license text as well.        *
 *                                                                         *
 * Because this license imposes special exceptions to the GPL, Covered     *
 * Work may not be combined (even as part of a larger work) with plain GPL *
 * software.  The terms, conditions, and exceptions of this license must   *
 * be included as well.  This license is incompatible with some other open *
 * source licenses as well.  In some cases we can relicense portions of    *
 * RFIDler or grant special permissions to use it in other open source     *
 * software.  Please contact sales@aperturelabs.com with any such requests.*
 * Similarly, we don't incorporate incompatible open source software into  *
 * Covered Software without special permission from the copyright holders. *
 *                                                                         *
 * If you have any questions about the licensing restrictions on using     *
 * RFIDler in other works, are happy to help.  As mentioned above, we also *
 * offer alternative license to integrate RFIDler into proprietary         *
 * applications and appliances.  These contracts have been sold to dozens  *
 * of software vendors, and generally include a perpetual license as well  *
 * as providing for priority support and updates.  They also fund the      *
 * continued development of RFIDler.  Please email sales@aperturelabs.com  *
 * for further information.                                                *
 * If you have received a written license agreement or contract for        *
 * Covered Software stating terms other than these, you may choose to use  *
 * and redistribute Covered Software under those terms instead of these.   *
 *                                                                         *
 * Source is provided to this software because we believe users have a     *
 * right to know exactly what a program is going to do before they run it. *
 * This also allows you to audit the software for security holes (none     *
 * have been found so far).                                                *
 *                                                                         *
 * Source code also allows you to port RFIDler to new platforms, fix bugs, *
 * and add new features.  You are highly encouraged to send your changes   *
 * to the RFIDler mailing list for possible incorporation into the         *
 * main distribution.  By sending these changes to Aperture Labs Ltd. or   *
 * one of the Aperture Labs Ltd. development mailing lists, or checking    *
 * them into the RFIDler source code repository, it is understood (unless  *
 * you specify otherwise) that you are offering the RFIDler Project        *
 * (Aperture Labs Ltd.) the unlimited, non-exclusive right to reuse,       *
 * modify, and relicense the code.  RFIDler will always be available Open  *
 * Source, but this is important because the inability to relicense code   *
 * has caused devastating problems for other Free Software projects (such  *
 * as KDE and NASM).  We also occasionally relicense the code to third     *
 * parties as discussed above. If you wish to specify special license      *
 * conditions of your contributions, just say so when you send them.       *
 *                                                                         *
 * This program is distributed in the hope that it will be useful, but     *
 * WITHOUT ANY WARRANTY; without even the implied warranty of              *
 * MERCHANTABILITY or FITNESS FOR A PARTICULAR PURPOSE.  See the RFIDler   *
 * license file for more details (it's in a COPYING file included with     *
 * RFIDler, and also available from                                        *
 *   https://github.com/ApertureLabsLtd/RFIDler/COPYING                    *
 *                                                                         *
 ***************************************************************************/

// Author: Adam Laurie <adam@aperturelabs.com>

#include "HardwareProfile.h"
#include "rfidler.h"
#include "q5.h"
#include "ask.h"
#include "rwd.h"
#include "util.h"
#include "comms.h"
#include "config.h"

const BYTE *Q5_Modulation[]= {"Manchester", "PSK1", "PSK2", "PSK3", "FSK1", "FSK2", "Biphase", "NRZ/Direct"};
const BYTE PSK_Rates[]= {2, 4, 8, 8};

// q5 needs special timings etc., so have a master send command routine to keep things simple
// response length in bits
BOOL q5_send_command(BYTE *response, BYTE *command, BYTE length, BOOL reset, BOOL sync, BYTE response_length)
{
    // send command
    if(!rwd_send(command, length, reset, BLOCK, RWD_STATE_START_SEND, RFIDlerConfig.FrameClock, Q5_START_GAP - RFIDlerConfig.RWD_Gap_Period, 0, RFIDlerConfig.RWD_Zero_Period, RFIDlerConfig.RWD_One_Period, RFIDlerConfig.RWD_Gap_Period, RFIDlerConfig.RWD_Wait_Switch_TX_RX))
        return FALSE;
        
    if(!response_length)
        return TRUE;

    // wait for Q5 damping to kick in: q5 may create a false pulse during RWD receipt, so wait for it to recognise
    // command and shut down before trying to read response.
    GetTimer_us(RESET);
    while(READER_DATA)
        if(GetTimer_us(NO_RESET) > RFIDlerConfig.Timeout)
            return FALSE;

    // skip leading '0'
    HW_Skip_Bits= 2;  // 2 primitive 'bits' manchester encoded
    
//    DEBUG_PIN_4= !DEBUG_PIN_4;
//    DEBUG_PIN_4= !DEBUG_PIN_4;
    if(read_ask_data(RFIDlerConfig.FrameClock, RFIDlerConfig.DataRate, response, response_length, RFIDlerConfig.Sync, sync ? RFIDlerConfig.SyncBits : 0, RFIDlerConfig.Timeout, ONESHOT_READ, HEX) == response_length)
    {
        // delay for RX->TX time
        Delay_us((RFIDlerConfig.FrameClock * RFIDlerConfig.RWD_Wait_Switch_RX_TX) / 100);
        return TRUE;
    }

    return FALSE;
}

// get raw UID
BOOL q5_get_uid(BYTE *response)
{
    BYTE tmp[17]; // 16 hex digits

    // q5 will be stuck if last command was a read or write, so always hard reset
    stop_HW_clock();

    // delay for sleep period
    Delay_us((RFIDlerConfig.FrameClock * RFIDlerConfig.RWD_Sleep_Period) / 100);

    // delay for startup time
    //Delay_us((RFIDlerConfig.FrameClock * RFIDlerConfig.RWD_Wake_Period) / 100);

    // q5 has fixed em4x02 style data in page 1
    if(q5_send_command(tmp, Q5_GET_TRACE_DATA, strlen(Q5_GET_TRACE_DATA), NO_RESET, SYNC, 64))
    {
        strcpy(response, tmp);
        return TRUE;
    }
    return FALSE;
}

// convert raw 64 bit HEX UID to 10 digit human readable hex
BOOL q5_hex_to_uid(BYTE *response, BYTE *hex)
{
    // q5 is the same as em4x02
    return em4x02_hex_to_uid(response, hex);
}

BOOL q5_read_block(BYTE *response, BYTE block)
{
    BYTE tmp[39], retry, reset= FALSE;

    if(block > Q5_DATABLOCKS - 1)
        return FALSE;

    // create 6 or 38 bit command block: Q5_DIRECT_ACCESS + PWD_Mode + [PWD] + 3 bits address
    memset(tmp, '\0', 39);
    memcpy(tmp, Q5_DIRECT_ACCESS, 2);
    if(PWD_Mode)
    {
        hextobinstring(tmp + 2, Password);
        tmp[34]= '0';
        inttobinstring(tmp + 35, (unsigned int) block, 3);
    }
    else
    {
        tmp[2]= '0';
        inttobinstring(tmp + 3, (unsigned int) block, 3);
    }

    retry= RFIDlerConfig.Repeat;
    while(retry--)
    {
        //DEBUG_PIN_4= !DEBUG_PIN_4;
        //DEBUG_PIN_4= !DEBUG_PIN_4;
        if(q5_send_command(response, tmp, strlen(tmp), reset, NO_SYNC, 32))
            return TRUE;
    }

    return FALSE;
}

// optional verify as writing config block may casue next read to fail
BOOL q5_write_block(BYTE block, BYTE *data, BOOL lock, BOOL verify)
{
    BYTE tmp[71], p;

    if(block > Q5_DATABLOCKS - 1)
        return FALSE;

    // create 38 or 70 bit command block: Q5_STD_WRITE_P0 + [PWD] + Lock Bit + 32 bits Data + 3 bits address
    memset(tmp, '\0', sizeof(tmp));

    // command
    memcpy(tmp, Q5_WRITE_P0, 2);
    p= 2;

    // password
    if(PWD_Mode)
    {
        hextobinstring(tmp + p, Password);
        p += 32;
    }

    // lockbit
    inttobinstring(tmp + p, (unsigned int) lock, 1);
    ++p;

    // data
    hextobinstring(tmp + p, data);
    p += Q5_BLOCKSIZE;

    // address
    inttobinstring(tmp + p, (unsigned int) block, 3);
    p += 3;

    // send
    if(!q5_send_command(NULL, tmp, strlen(tmp), NO_RESET, NO_SYNC, 0))
         return FALSE;
    
    // no ack, so read back and verify
    // delay for long enough to allow write plus TX->RX period
    Delay_us((Q5_WRITE_DELAY * RFIDlerConfig.FrameClock + RFIDlerConfig.RWD_Wait_Switch_TX_RX * RFIDlerConfig.FrameClock) / 100L);
    
    if(!verify)
        return TRUE;

    if(!q5_read_block(tmp, block))
        return FALSE;
    if(memcmp(tmp, data, HEXDIGITS(Q5_BLOCKSIZE)) != 0)
        return FALSE;

    return TRUE;
}

// set password and mode, and return UID
BOOL q5_login(BYTE *response, BYTE *pass)
{
    BYTE tmp[36];

    // check we need password - if we can get UID without, then we don't
    if(q5_get_uid(tmp))
        return FALSE;

    if(strlen(pass) == 0)
        pass= Q5_DEFAULT_PWD;

    memcpy(tmp, Q5_AOR, 2);
    hextobinstring(tmp + 2, pass);
    tmp[34]= '\0';

    // send password
    if (!q5_send_command(NULL, tmp, strlen(tmp), NO_RESET, NO_SYNC, 0))
        return FALSE;

    // see if we can now get UID
    if(!q5_get_uid(tmp))
        return FALSE;

    PWD_Mode= TRUE;
    strcpy(Password, pass);
    strcpy(response, pass);
    return TRUE;
}

// try to find values that correctly transmit all commands to q5
// to test this properly, q5 should have invalid data in it's data blocks
// so that only a GET_TRACE_DATA command will return a true value
BOOL q5_rwd_test(BYTE *pattern)
{
    BYTE gap, one, zero, tmp[Q5_BLOCKSIZE + 1];
    BOOL found= FALSE, blank;

    // min/max from datasheets
    for(one= 48 ; one <= 63 ; ++one)
        for(zero= 16; zero <= 31 ; ++zero)
            for(gap=  10 ; gap <= 50 ; ++gap)
            {
                RFIDlerConfig.Manchester= TRUE;
                blank= TRUE;
                if(get_user_abort())
                    return found;
                RFIDlerConfig.RWD_Gap_Period= gap;
                RFIDlerConfig.RWD_One_Period= one;
                RFIDlerConfig.RWD_Zero_Period= zero;
                // reset tag
                get_tag_uid(tmp);
                // try to switch off modulation
                rwd_send(Q5_MODULATION_DEFEAT, strlen(Q5_MODULATION_DEFEAT), NO_RESET, BLOCK, RWD_STATE_START_SEND, RFIDlerConfig.FrameClock, RFIDlerConfig.RWD_Gap_Period, 0, RFIDlerConfig.RWD_Zero_Period, RFIDlerConfig.RWD_One_Period, RFIDlerConfig.RWD_Gap_Period, RFIDlerConfig.RWD_Wait_Switch_TX_RX);
                // read a block with no sync & no manchester - will be all '0' if not modulating
                RFIDlerConfig.Manchester= FALSE;
                if(read_ask_data(RFIDlerConfig.FrameClock, RFIDlerConfig.DataRate, tmp, RFIDlerConfig.DataBits, RFIDlerConfig.Sync, 0, RFIDlerConfig.Timeout, NO_ONESHOT_READ, HEX) == RFIDlerConfig.DataBits)
                {
                    if(strcmp(tmp, "0000000000000000") != 0)
                            blank= FALSE;
                    RFIDlerConfig.Manchester= TRUE;
                    if(blank && get_tag_uid(tmp) && q5_read_block(tmp, 0))
                    {
                        UserMessageNum("\r\nFound tag with gap %d", gap);
                        UserMessageNum(" one %d", one);
                        UserMessageNum(" zero %d", zero);
                        found= TRUE;
                    }
                }
            }
    UserMessage("%s", "\r\n");
    return found;
}

BOOL q5_config_block_show(BYTE *config, BYTE *password)
{
    uint32_t    value= hextoulong(config);

    UserMessage("  Config Block (0): %.8s\r\n\r\n", config);
    UserMessage("       Page Select: %s\r\n", GET_CONFIG(value, Q5_MASK_PAGE_SELECT, Q5_SHIFT_PAGE_SELECT) ? "True" : "False");
    UserMessage("        Fast Write: %s\r\n", GET_CONFIG(value, Q5_MASK_FAST_WRITE, Q5_SHIFT_FAST_WRITE) ? "True" : "False");
    UserMessageNum("         Data Rate: %02d = ", GET_CONFIG(value, Q5_MASK_DATA_BIT_RATE, Q5_SHIFT_DATA_BIT_RATE));
    UserMessageNum("%d * FC\r\n", GET_CONFIG(value, Q5_MASK_DATA_BIT_RATE, Q5_SHIFT_DATA_BIT_RATE) * 2 + 2);
    UserMessage("           Use AOR: %s\r\n", GET_CONFIG(value, Q5_MASK_USE_AOR, Q5_SHIFT_USE_AOR) ? "True" : "False");
    UserMessage("           Use PWD: %s\r\n", GET_CONFIG(value, Q5_MASK_USE_PWD, Q5_SHIFT_USE_PWD) ? "True" : "False");
    UserMessageNum("       PSK Carrier: %d  = ", GET_CONFIG(value, Q5_MASK_PSK_CARRIER_FREQ, Q5_SHIFT_PSK_CARRIER_FREQ));
    UserMessageNum("%d * FC\r\n", PSK_Rates[GET_CONFIG(value, Q5_MASK_PSK_CARRIER_FREQ, Q5_SHIFT_PSK_CARRIER_FREQ)]);
    UserMessage("      Inverse Data: %s\r\n", GET_CONFIG(value, Q5_MASK_INVERSE_DATA, Q5_SHIFT_INVERSE_DATA) ? "True" : "False");
    UserMessageNum("        Modulation: %d  = ", GET_CONFIG(value, Q5_MASK_MODULATION, Q5_SHIFT_MODULATION));
    UserMessage("%s\r\n", (BYTE *) Q5_Modulation[GET_CONFIG(value, Q5_MASK_MODULATION, Q5_SHIFT_MODULATION)]);
    UserMessageNum("         Max Block: %d\r\n", GET_CONFIG(value, Q5_MASK_MAX_BLOCK, Q5_SHIFT_MAX_BLOCK));
    UserMessage("                ST: %s\r\n", GET_CONFIG(value, Q5_MASK_ST, Q5_SHIFT_ST) ? "True" : "False");
    
    UserMessage("\r\n     PWD Block (7): %.8s    ", password);
    printhexreadable(password, 4);
    UserMessage("%s", "\r\n");
    return TRUE;
}

// create a config block based on current tag settings
BOOL q5_create_config_block(BYTE *config)
{
    uint32_t    value= hextoulong(config);
    BYTE        tmp;

    // data rate
    value= SET_CONFIG(value, Q5_MASK_DATA_BIT_RATE, Q5_SHIFT_DATA_BIT_RATE, (RFIDlerConfig.DataRate - 2) / 2);

    // psk sub-carrier
    if((tmp= RFIDlerConfig.DataRateSub0))
    {
        if(tmp == 2)
            tmp= 0;
        else
            if (tmp == 4)
                tmp= 1;
            else
                tmp= 2;
        value= SET_CONFIG(value, Q5_MASK_PSK_CARRIER_FREQ, Q5_SHIFT_PSK_CARRIER_FREQ, tmp);
    }

    // modulation
    if(RFIDlerConfig.Manchester && RFIDlerConfig.Modulation == MOD_MODE_ASK_OOK)
        tmp= Q5_MOD_MANCHESTER;
    else
    {
        if(RFIDlerConfig.BiPhase && RFIDlerConfig.Modulation == MOD_MODE_ASK_OOK)
            tmp= Q5_MOD_BIPHASE;
        else
            switch(RFIDlerConfig.Modulation)
            {
                case MOD_MODE_ASK_OOK:
                    tmp= Q5_MOD_DIRECT;
                    break;
                case MOD_MODE_FSK1:
                    tmp= Q5_MOD_FSK1;
                    break;
                case MOD_MODE_FSK2:
                    tmp= Q5_MOD_FSK2;
                    break;
                case MOD_MODE_PSK1:
                    tmp= Q5_MOD_PSK1;
                    break;
                case MOD_MODE_PSK2:
                    tmp= Q5_MOD_PSK2;
                    break;
                case MOD_MODE_PSK3:
                    tmp= Q5_MOD_PSK3;
                    break;
                default:
                    return FALSE;
            }
    }
    value= SET_CONFIG(value, Q5_MASK_MODULATION, Q5_SHIFT_MODULATION, tmp);

    // data blocks
    value= SET_CONFIG(value, Q5_MASK_MAX_BLOCK, Q5_SHIFT_MAX_BLOCK, RFIDlerConfig.DataBits / Q5_BLOCKSIZE);

    ulongtohex(config, value);

    return TRUE;
}

// set a config block suitable for emulating
BOOL q5_emulate_config_block(BYTE *config, BYTE target_tagtype)
{
    switch (target_tagtype)
    {
       case TAG_TYPE_ASK_RAW:
       case TAG_TYPE_FSK1_RAW:
       case TAG_TYPE_FSK2_RAW:
       case TAG_TYPE_PSK1_RAW:
       case TAG_TYPE_PSK2_RAW:
       case TAG_TYPE_PSK3_RAW:
           memcpy(config, Q5_DEFAULT_CONFIG_BLOCK, HEXDIGITS(Q5_BLOCKSIZE));
           q5_create_config_block(config);
           return TRUE;

       case TAG_TYPE_AWID_26:
       case TAG_TYPE_HID_26:
            memcpy(config, Q5_HID_26_CONFIG_BLOCK, HEXDIGITS(Q5_BLOCKSIZE));
            return TRUE;

        case TAG_TYPE_FDXB:
            memcpy(config, Q5_FDXB_CONFIG_BLOCK, HEXDIGITS(Q5_BLOCKSIZE));
            return TRUE;

        case TAG_TYPE_INDALA_64:
            memcpy(config, Q5_INDALA_64_CONFIG_BLOCK, HEXDIGITS(Q5_BLOCKSIZE));
            return TRUE;

        case TAG_TYPE_INDALA_224:
            memcpy(config, Q5_INDALA_224_CONFIG_BLOCK, HEXDIGITS(Q5_BLOCKSIZE));
            return TRUE;

        case TAG_TYPE_EM4X02:
        case TAG_TYPE_Q5:
        case TAG_TYPE_UNIQUE:
        case TAG_TYPE_PAXTON:
            memcpy(config, Q5_DEFAULT_CONFIG_BLOCK, HEXDIGITS(Q5_BLOCKSIZE));
            return TRUE;

        default:
            return FALSE;
    }
}

// decode externally sniffed PWM
BOOL q5_decode_pwm(unsigned int pulses[], unsigned int gaps[], unsigned int count)
{
    unsigned int    i;
    BOOL            decoded= FALSE, sequence;
    static BOOL     pwd= FALSE;
    BYTE            tmp[18], out[71], *p; // max response from q5 is 70 bits
    
    i= 0;
    while(i < count)
    {
        // we can't use generic_decode_pwm as Q5 commands may be all 0 or all 1
        for(p= out, sequence= FALSE ; i < count ; ++i)
            if(gaps[i] >= 100 && gaps[i] <= 512)
            {
                // make sure invalid data doesn't overrun buffer
                if(p - out == sizeof(out) - 2)
                    break;
                
                if(pulses[i] <= 512)
                {
                    if(approx(pulses[i], 128, 20))
                        *(p++)= '0';
                    else
                        *(p++)= '1';
                    sequence= TRUE;
                }
                else
                {
                    ++i;
                    break;
                }
            }
        *p= '\0';
        
        if(sequence)
        {
            // there are only 7 message sizes, so decode accordingly
            switch(strlen(out))
            {
                // GET Trace Data (UID)) or RESET
                case 2:
                    if(memcmp(out, Q5_GET_TRACE_DATA, 2) == 0)
                        UserMessage("\r\n%s, GET_TRACE_DATA", out);
                    else
                        if(memcmp(out, Q5_SOFT_RESET, 2) == 0)
                            UserMessage("\r\n%s, RESET", out);
                        else
                            UserMessage("\r\n%s, ?INVALID?", out); 
                    break;
                
                // modulation defeat
                case 5:
                    if(memcmp(out, Q5_MODULATION_DEFEAT, 5) == 0)
                        UserMessage("\r\n%s, MODULATION_DEFEAT", out);
                    else
                        UserMessage("\r\n%s, ?INVALID?", out); 
                    break;
                    
                // read
                case 6:
                    if(memcmp(out, Q5_DIRECT_ACCESS, 2) == 0)
                        UserMessage("\r\n%s, DIRECT_ACCESS:", out);
                    else
                    {
                        UserMessage("\r\n%s, ?INVALID?", out); 
                        break;
                    }
                    // PWD mode (should be 0))
                    UserMessage("%0.1s:", out + 2);
                    // ADDRESS
                    binstringtohex(tmp, out + 3);
                    UserMessage("%0.2s", tmp);
                    pwd= FALSE;
                    break;
                    
                // login (AOR followed by PWD)
                case 34:
                    if(memcmp(out, Q5_AOR, 2) == 0)
                        UserMessage("\r\n%s, AOR:", out);
                    else
                    {
                        UserMessage("\r\n%s, ?INVALID?", out); 
                        break;
                    }
                    // PWD
                    binstringtohex(tmp, out + 2);
                    UserMessage("%0.8s", tmp);
                    pwd= TRUE;
                    break;
                
                // PWD read/ STD write
                // note the only way to tell these apart is by knowing we are in PWD mode
                case 38:
                    if(pwd && memcmp(out, Q5_DIRECT_ACCESS, 2) == 0)
                    {
                        UserMessage("\r\n%s, PWD_DIRECT_ACCESS:", out);
                        // PWD
                        binstringtohex(tmp, out + 2);
                        UserMessage("%0.8s:", tmp);
                        // Lock BIT
                        UserMessage("%0.1s:", out + 34);
                        // ADDRESS
                        binstringtohex(tmp, out + 35);
                        UserMessage("%0.1s", tmp);
                        break;
                    }
                    
                    if(!pwd && memcmp(out, Q5_WRITE_P0, 2) == 0)
                        UserMessage("\r\n%s, WRITE_P0:", out);
                    else
                    {
                        UserMessage("\r\n%s, ?INVALID?", out); 
                        break;
                    }
                    // Lock BIT
                    UserMessage("%0.1s:", out + 2);
                    // DATA
                    binstringtohex(tmp, out + 3);
                    UserMessage("%0.8s:", tmp);
                    // ADDRESS
                    binstringtohex(tmp, out + 35);
                    UserMessage("%0.1s", tmp);
                    break;
                    
                // PWD write
                case 70:
                    if(memcmp(out, Q5_WRITE_P0, 2) == 0)
                        UserMessage("\r\n%s, PWD_WRITE_P0:", out);
                    else
                    {
                        UserMessage("\r\n%s, ?INVALID?", out); 
                        break;
                    }
                    // PWD
                    binstringtohex(tmp, out + 2);
                    UserMessage("%0.8s:", tmp);
                    // Lock BIT
                    UserMessage("%0.1s:", out + 34);
                    // DATA
                    binstringtohex(tmp, out + 35);
                    UserMessage("%0.8s:", tmp);
                    // ADDRESS
                    binstringtohex(tmp, out + 67);
                    UserMessage("%0.1s", tmp);
                    pwd= TRUE;
                    break;
                    
                default:
                    UserMessage("\r\n%s, ?INVALID?", out);
                    break;
            }
            decoded= TRUE;
        }
    }
    
    UserMessage("%s", "\r\n");
    
    return decoded;
}
