AdamLaurie/RFIDler/windows-src/RFIDler-mon/resource.h

//{{NO_DEPENDENCIES}}
// Microsoft Visual C++ generated include file.
// Used by rfidlermonitor.rc
//
#define IDI_RFIDLER                     100
#define IDI_DEVBOARD                    101
#define IDI_DEVBOARDBAD                 102
#define IDI_DEVBOARDREMOVE              103
#define IDI_OTHERSERIALOK               104
#define IDI_OTHERSERIALREMOVE           105
#define IDI_RFIDBAD                     106
#define IDI_RFIDBOOT                    107
#define IDI_RFIDOKAY                    108
#define IDI_RFIDREMOVE                  109
#define IDD_MONITOR                     110
#define IDD_OPTIONS                     111
#define IDR_MAINMENU                    112
#define IDD_WHATTOWATCH                 113
#define IDD_NOTIFICATIONS               114
#define IDD_CONFIGSHORTCUTS             115
#define IDR_BOOTLOADER_CONTEXT          116
#define IDR_COMPORT_CONTEXT             117
#define IDR_RFIDLER_CONTEXT             118
#define IDD_HELP_ABOUT                  119
#define IDD_DEVICE_DETAILS              121
#define IDD_BOOTLOADERFLASH             124
#define IDC_RFID_ARR_FLASH              1000
#define IDC_RFIDLERLIST                 1001
#define IDC_SHOW_UNCONFIG               1002
#define IDC_APPLY                       1003
#define IDC_SHOW_ALL                    1004
#define IDC_SHOW_DEV_BOARDS             1005
#define IDC_SHOW_RECENTDISC             1006
#define IDC_CHECK_SHOW_ALL              1007
#define IDC_CHECK_SHOW_NONE             1008
#define IDC_BOOT_ARR_FLASH              1010
#define IDC_MICROCHIP_ARR_FLASH         1011
#define IDC_ALL                         1012
#define IDC_NONE                        1013
#define IDC_OTHERSERIAL                 1014
#define IDC_TABOPTIONS                  1015
#define IDC_PROGPATH                    1016
#define IDC_SHORTCUTPATH                1017
#define IDC_STATUSBAR                   1018
#define IDC_DESKNO                      1019
#define IDC_DESKYES                     1020
#define IDC_STARTNO                     1021
#define IDC_STARTYES                    1022
#define IDC_HELP_TEXT                   1025
#define IDC_DEFAULT                     1026
#define IDC_FLASHREPORT                 1027
#define IDC_ERASE                       1028
#define IDC_PROGRAM                     1029
#define IDC_HEX_READFILE                1030
#define IDC_BROWSE                      1031
#define IDC_VERIFY                      1032
#define IDC_ERASEPROGRAMVERIFY          1033
#define IDC_REBOOT                      1034
#define IDC_SAVEHEX                     1035
#define IDC_FLASHPROGRESS               1036
#define IDC_ARRIVAL_REMOVAL_TIME        1037
#define IDC_ARRIVAL_BUDDY               1038
#define IDC_DEV_DETAILS                 1057
#define ID_HELP_ABOUT                   40001
#define ID_MONITOR_EXIT                 40007
#define ID_VIEW_LARGE_ICONS             40008
#define ID_VIEW_SMALL_ICONS             40009
#define ID_VIEW_DETAILS                 40010
#define ID_VIEW_TILES                   40011
#define ID_CONTEXT_COPYDEV_DETAILS      40014
#define ID_CONTEXT_COPYPORT_NAME        40015
#define ID_CONTEXT_COPYPORT_DETAILS     40016
#define ID_CONTEXT_COPYALL_DETAILS      40017
#define ID_CONTEXT_OPEN_FOR_REFLASH     40020
#define ID_SETTINGS_DEVTYPES            40022
#define ID_SETTINGS_DEVNOTIFICATIONS    40023
#define ID_SETTINGS_CONFIG_SHORTCUTS    40024
#define ID_CONTEXT_REBOOT_FOR_REFLASH   40025
#define ID_CONTEXT_PORT_DETAILS         40026
#define ID_CONTEXT_RFIDLER_DETAILS      40027
#define ID_CONTEXT_BOOTLOADER_DETAILS   40028
#define ID_CONTEXT_REBOOT               40029
#define ID_CONTEXT_BOOTLOADER_REBOOT    40030

// Next default values for new objects
// 
#ifdef APSTUDIO_INVOKED
#ifndef APSTUDIO_READONLY_SYMBOLS
#define _APS_NEXT_RESOURCE_VALUE        125
#define _APS_NEXT_COMMAND_VALUE         40031
#define _APS_NEXT_CONTROL_VALUE         1071
#define _APS_NEXT_SYMED_VALUE           101
#endif
#endif
