AdamLaurie/RFIDler/(commit log)

2014-06-13 fix low level memory corruption caused by poor initialisation of tmp storage
    [ask.c, fsk.c, psk.c]
2014-06-13 better pot setting for hid26 on beta board
2014-06-14 Create symlink against the tty device, not the usb device - closes #1
2014-06-14 Resolve build issues with macosx and xc32 1.32
    * Changed VERSION define to use 'git rev-list HEAD --count'
    to avoid issue on MacOSX where the result from wc is indented
    and causes an invalid build command.
    * Added define _SUPPRESS_PLIB_WARNING to remove warnings
    about depricated headers being used.
    [main.c]
2014-06-15 blacklist device symlink as well as main tty for linux modem manager
2014-06-16 fix analogue buffer size check
    [main.c]
2014-06-16 rename some xml components and use correct slash for item end
    [analogue.c, util.c]
2014-06-20 fix FREQUENCY command hanging in API mode
    [main.c]
2014-06-20 switch HID and AWID Prox to 134.2KHz (and cleaner em4x02 plot image)
2014-06-24 allow setting of pots in volts. plot in volts.
2014-06-30 use current XC32 compiler (v1.32) - note this means you must use updated mphidflash (v1.4)
2014-06-30 remove redundant buffers pointers from analogue sampling (as we use a fixed buffer)
    [analogue.c, analogue.h, main.c]
2014-07-02 fix iso7816 buffer size. temporarily reduce history buffer size to work around memory corruption - NEEDS FIXING PROPERLY!!
    [iso7816.c, iso_7816.h, main.c, rfidler.h]
2014-07-12 use existing buffer for analogue samples to save on memory
2014-07-12 fix ASK logic error (non manchester/biphase data was always inverted) & string terminate read buffers for all modulation schemes
    [ask.c, fsk.c, isr.c, psk.c]
2014-09-13 add TRESET command - reset TAG's config block to default
    [main.c, q5.c, rfidler.h]
2014-09-15 add TWIPE command (tag wipe), allow password for TRESET & TWIPE, various minor bug fixes, start on T55X7 support (not yet working)
    [config.c, hitag.c, login.c, main.c, q5.h, read.c, t55x7.c, t55x7.h]
2014-09-29 T55X7 mostly working, start on plot with external clock, add some missing headers
    [analogue.c, analogue.h, ask.c, awid.c, config.c, hid.c, main.c, q5.c]
2014-10-22 fix HITAG1. tidy up sync pattern matching.
    [ask.c, fsk.c, hitag.c, psk.c, tags.c]
2014-10-24 fix potential buffer overflow in HITAG2. implement HITAG1 write.
    [hitag.c, hitag.h, rfidler.h, write.c]
2014-11-13 RFIDler Installer for Windows
    First public release of RFIDler Installer tool, for public feedback.
    Helps install / uninstall Windows driver for RFIDler LF. Binaries
    supplied for x86 and x64.
2014-11-14 RFIDler Monitor minor bug fix
    Fix status bar count of Microchip dev boards.
    Minor fixes putting repeated code into functions.
    [rfidmonitor.cpp]
2014-11-16 RFIDler Monitor image
    Here is how the RFIDler Monitor looks with 2 devices connected. (Also
    one other serial device, with options to show all serial devices
    enabled.)
2014-11-18 Made sprintf into safer snprintf to avoid overflows
    [comms.c]
2014-11-20 minor fixes
    Including: correct initial options values, fix menu to work with
    keyboard, fix Options dialog to work with Tab key, fix memory leak from
    Options dialog.
    [rfidmonitor.cpp]
2014-11-20 RFIDler Monitor for Windows fix Options dialog bug
    'None' button did not work correctly for Notifications tab.
    Also add a 'Default Values' button to the dialog.
    [resource.h, rfidmonitor.cpp]
2014-11-21 - Added functionality to dump a reading:
    #./rfidler.py /dev/RFIDler 'set tag askraw' 'potset h 150' 'set fc 745' 'set rate 33' dump 6000
    sending 'SET TAG ASKRAW'
    sending 'POTSET H 150'
    sending 'SET FC 745'
    sending 'SET RATE 33'
    Wrote dump to dump_20141121-075357.xml
    - Added functionality to plot from a previously saved reading:
    #./rfidler.py /dev/RFIDler load dump_20141121-075357.xml
    - Added some logic to print out bit periods, i.e. the number of samples before the next toggling (not the true bit period, just to help determine the true bit period)
2014-11-22 Output from ANALOGUE 100, when instead of using the actual value from read_adc(), we've put 0xAAAAAA as the ADC value instead. As can be seen, the sprintf to databuffer overwrites the first two bytes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
    Before patch:
    <Description>Time Based Sample Arrays</Description>
    <Coil_Data>
    <Description>Analogue Circuit Raw Data (HEX)</Description>
    <Data>
    303000a8a8a8a8a8a8a8a8a8a8a8a8a8a8a8a8a8a8a8a8a8a8a8a8a8a8a8a8a8
    a8a8a8a8a8a8a8a8a8a8a8a8a8a8a8a8a8a8a8a8a8a8a8a8a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
2014-11-22 Oops, forgot to reset some test values
    [analogue.c]
2014-11-26 Add basic instructions for flashing device on OSx
2015-03-27 switch back to production build by default
2015-04-28 update RFIDler Monitor for Windows to v 1.0.3
    split into multiple .cpp files and one .h file
    add new sort orders to sort by column in reverse
    improvement device context menu
    refactor duplicated code into common function
    [deviceinfo.cpp, devicetracker.cpp, monitoroptions.cpp, resource.h, rfidmonitor.cpp, rfidmonitor.h, wcs_utilities.cpp]
2015-05-29 Windows RFIDLer Installer v0.2
    Minor update:
    rename rfidinstall.c to rfidinstall.cpp
    tidy code, improve some comments
    make install dialog prettier
    tweak program icon
    Windows >= 7 : Add Install Progress bar to Taskbar icon
    fix dialog frame size
    [resource.h]
2015-05-30 Windows RFIDler Installer v0.21
    Minor fixes:
    Beautify progress bar stuff
    Try to improve text about driver signing
2015-06-17 fix hang when using FSK on non-FSK tags
    [fsk.c]
2015-06-17 change RWD timers to only use carrier clock ticks. start to implement EM4x05 (not yet working). some minor tidy ups.
2015-06-19 add SNIFF-PWM command. allow setting of coil state when shutting down coil for PWM.
2015-06-19 add PWM sniffing for Q5/T55X7. increase sniffer buffer size.
2015-06-19 auto calculate ZERO and ONE pulse sizes for SNIFF-PWM
2015-06-19 sniff HITAG1 PWM
2015-06-20 fix variable type error in SNIFF-PWM. start work on more detailed decode.
    [hitag.c, hitag.h, q5.c, q5.h, sniff.c, sniff.h]
2015-06-21 full decode of HITAG2 in SNIFF-PWM. improve randomness for HITAG2 crypto mode.
2015-06-22 oops. missed em.c from commit (still not working though! :)
    [em.c, hitag.c]
2015-06-22 fix losing initial 1/2 bit when manchester encoded ASK. initial support for EM4X05 (UID, DUMP/READ/COPY working)
    [em.c, em.h, isr.c, q5.c, read.c, t55x7.c, tags.c]
2015-06-23 ASK manchester fix broke HITAG2. fixed.
    [hitag.c, tags.c]
2015-06-24 fix FDXB (ASK bit error). only use BYTE for HITAG2 config. only print correct portion of PWD. fix typo in HITAG2 config printout.
    [fdxb.c, hitag.c, hitag.h, q5.c, t55x7.c, util.c, util.h]
2015-06-24 show more info in TCONFIG. show EM4X05 info. try to fix read error when switching from FSK to ASK (work in progress)
    [clock.c, config.c, config.h, em.c, em.h, hitag.c, hitag.h, isr.c]
2015-06-25 fix timing issue where reader ISR could fire twice. small tidy up.
    [HardwareProfile.h, ask.c, clock.c, fsk.c, isr.c]
2015-06-27 fix error when setting modulation in config block for EM4X05
    [em.c]
2015-07-02 SNIFF-PWM decoder for HITAG1 (plaintext commands only so far)
2015-07-06 Minor style fixes to Indala64 verify
    also fix lower case hex handling
    [indala.c]
2015-07-09 Q5 PWM sniff decoder. HEX files now include Indala CRC.
2015-07-10 use unsigned int instead of unsigned long for SNIFF-PWM. fix buffer overflow in Q5 sniff.
    [hitag.c, hitag.h, q5.c, q5.h, sniff.c, sniff.h, tamagotchi.c, tamagotchi.h]
2015-07-12 add TAMAGOTCHI to SNIFF-PWM (instead of merging #25 which had too many conflicts)
2015-08-08 Windows Rfidler Monitor - fixed icon, give up changing icon to reflect num devices
    New icon depicts a Rfidler board and coil, and id card to read.
    Minor edits to comments, class names, white space to improve
    readability.
    [devicetracker.cpp, resource.h, rfidmonitor.cpp, rfidmonitor.h]
2015-08-09 Windows Rfidler Monitor - Minor bug fix, and minor refactoring
    Only count Microchip development board (eg USB BitWhacker32) arrival & removal
    when option is enabled.
    [devicetracker.cpp, monitoroptions.cpp, rfidmonitor.cpp, rfidmonitor.h]
2015-08-09 Windows Rfidler Monitor - add Windows Version testing & compatibility manifest
    Also add tracking of the Taskbar so that we can in future add icon
    overlays or Taskbar progress indicator.
    Minor tidying; project no longer references obsolete icon files.
    [resource.h, rfidmonitor.cpp, rfidmonitor.h, taskbarfeatures.cpp, windowsversion.cpp]
2015-08-10 Windows Rfidler Monitor - tweak Settings related menu, refactoring
    Make DeviceTracker a proper singleton.
    In Device List distinguish serial, modem & multiport.
    Fix resource release bug during program exit.
    Remove unneeded 'static's.
    [deviceinfo.cpp, devicetracker.cpp, resource.h, rfidmonitor.cpp, rfidmonitor.h]
2015-08-10 Windows Rfidler Monitor - allow config of time we remember disconnected devices
    Edit time value, save & restore on program restart.
2015-08-30 Windows Driver Installer v0.3 release
    Refine UI, detect Windows 8 or 10
    Add option to uninstall only disconnected RFIDlers
    Report COM port numbers as they are uninstalled
2015-11-25 add RFIDler board purchase link
2016-01-19 Windows RFIDler Driver Install v0.3.1
    Improve error reporting when uninstalling driver .inf
    Minor UI tweaks: keyboard shortcuts
    Help dialog reads fileversion info
2016-02-01 document WIRING aliases: PINS, WIRES
2016-03-13 Fix Indala uninitialized variable in parity check (issue #30) [bvernoux]
    [indala.c]
2016-03-13 disable HDX until actually working (issue #29)
    [hdx.c]
2016-12-14 ensure target tag is reset after cloning
    [vtag.c]
2017-09-15 add hitag2 cracking [Kevin Sheldrake <kev@headhacking.com>]
    [HardwareProfile.h, hitag.c, hitag2crack.c, hitag2crack.h, hitagcrypto.c, main.c, nvm.c, rfidler.h]
2018-01-09 Added crack4 from Lock It and Still Lose It
    [HardwareProfile.h, hitagcrypto.c, rfidler.h, util.h]
2018-01-09 Fixed HITAG2-READER to work with protected tags
    [hitag2crack.c]
2024-07-21 Code no longer needs device connection to Load & Plot Missing plot Libraries nolonger Error Fixed Help text Spelling Updated python/README.md
