AdamLaurie/RFIDler/(notices)

Notices in the files:
firmware/Pic32/RFIDler.X/src/main.c:
A copy of the GNU GPL is appended to this file.
RFIDler is (C) 2013-2017 Aperture Labs Ltd.
under the terms of the GNU General Public License as published by the
Free Software Foundation; Version 2 ("GPL"), BUT ONLY WITH ALL OF THE
CLARIFICATIONS AND EXCEPTIONS DESCRIBED HEREIN. This guarantees your
Note that the GPL places important restrictions on "derivative works",
yet it does not provide a detailed definition of that term. To avoid
the plain GPL differently, so we consider this a special exception to
the GPL that we apply to Covered Software. Works which meet any of
these conditions must conform to all of the terms of this license,
particularly including the GPL Section 3 requirements of providing
firmware/Pic32/RFIDler.X/src/em.c:
RFIDler is (C) 2013-2015 Aperture Labs Ltd.
firmware/Pic32/RFIDler.X/src/q5.c:
RFIDler is (C) 2013-2014 Aperture Labs Ltd.
Hardware/Pic32/RFIDLER V22 beta.brd:
RFIDLER V22 BETA (c) 2014
parts and their libraries:
SparkFun-Capacitors: Licensing: CC v3.0 Share-Alike You are welcome to use this library for commercial purposes.
